jeremy-daily/SSS2/RawHID/README.md

# RawHID for SSS2
This is a development directory to use the human interface device for communication with the PC from the SSS2.
