jeremy-daily/SSS2/docs/SSS-2.0 v5 Schematics.pdf

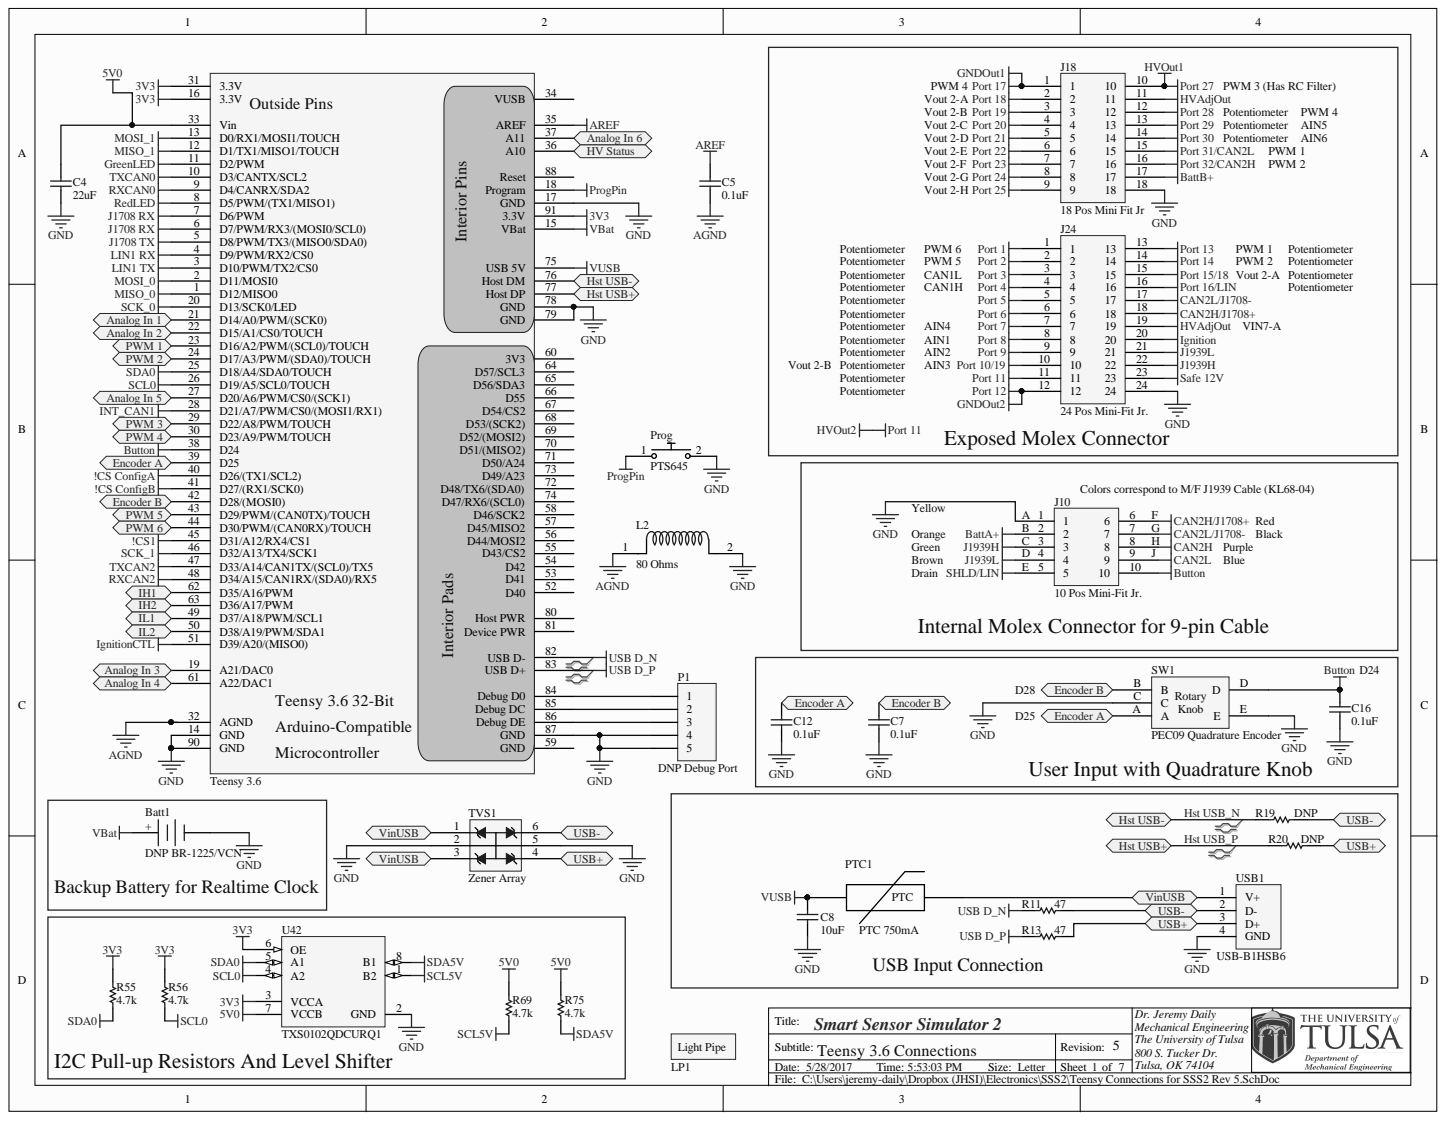
[picture p1: page 1]

Interior Pins Interior Pads

24 Pos Mini-Fit Jr.

10 Pos Mini-Fit Jr.

Internal Molex Connector for 9-pin Cable

User Input with Quadrature Knob

Backup Battery for Realtime Clock

Dr. Jeremy Daily
Mechanical Engineering
The University of Tulsa
800 S. Tucker Dr.
Tulsa, OK 74104

Subtitle:
C:\Users\jeremy-daily\Dropbox (JHSI)\Electronics\SSS2\Teensy Connections for SSS2 Rev 5.SchDoc

I2C Pull-up Resistors And Level Shifter

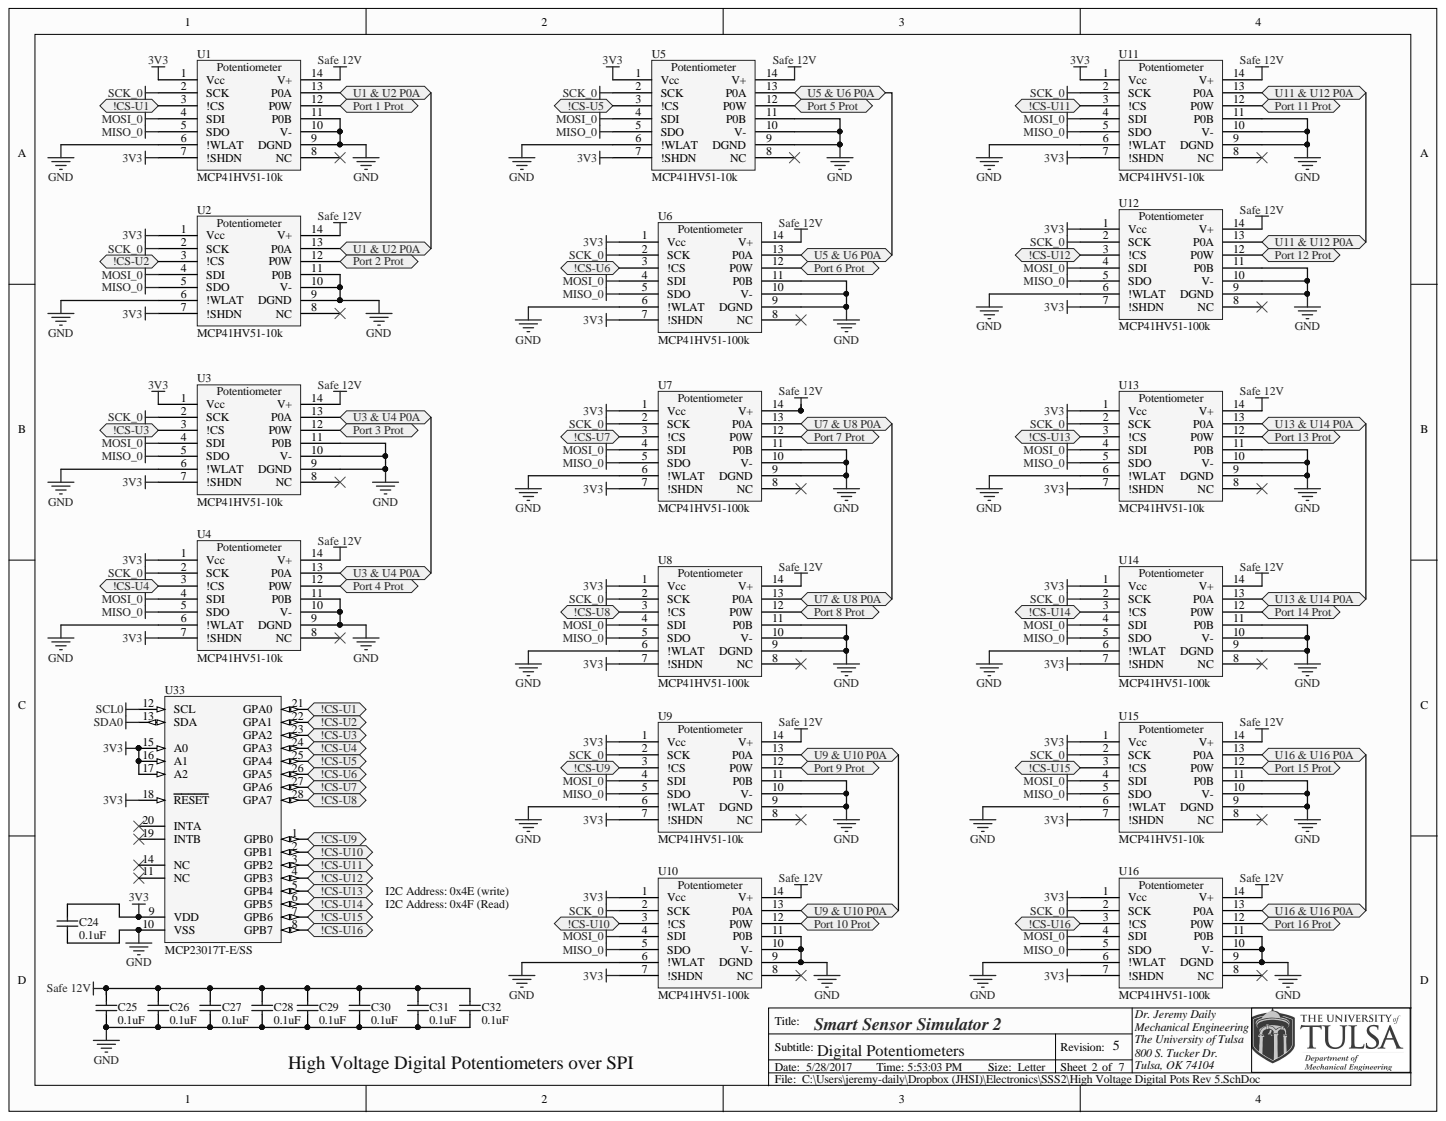
[picture p2: page 2]

Title: Smart Sensor Simulator 2 | Dr. Jeremy Daily 800 S. Tucker Dr.

Digital Potentiometers | 5

High Voltage Digital Potentiometers over SPI

C:\Users\jeremy-daily\Dropbox (JHSI)\Electronics\SSS2\High Voltage Digital Pots Rev 5.SchDoc

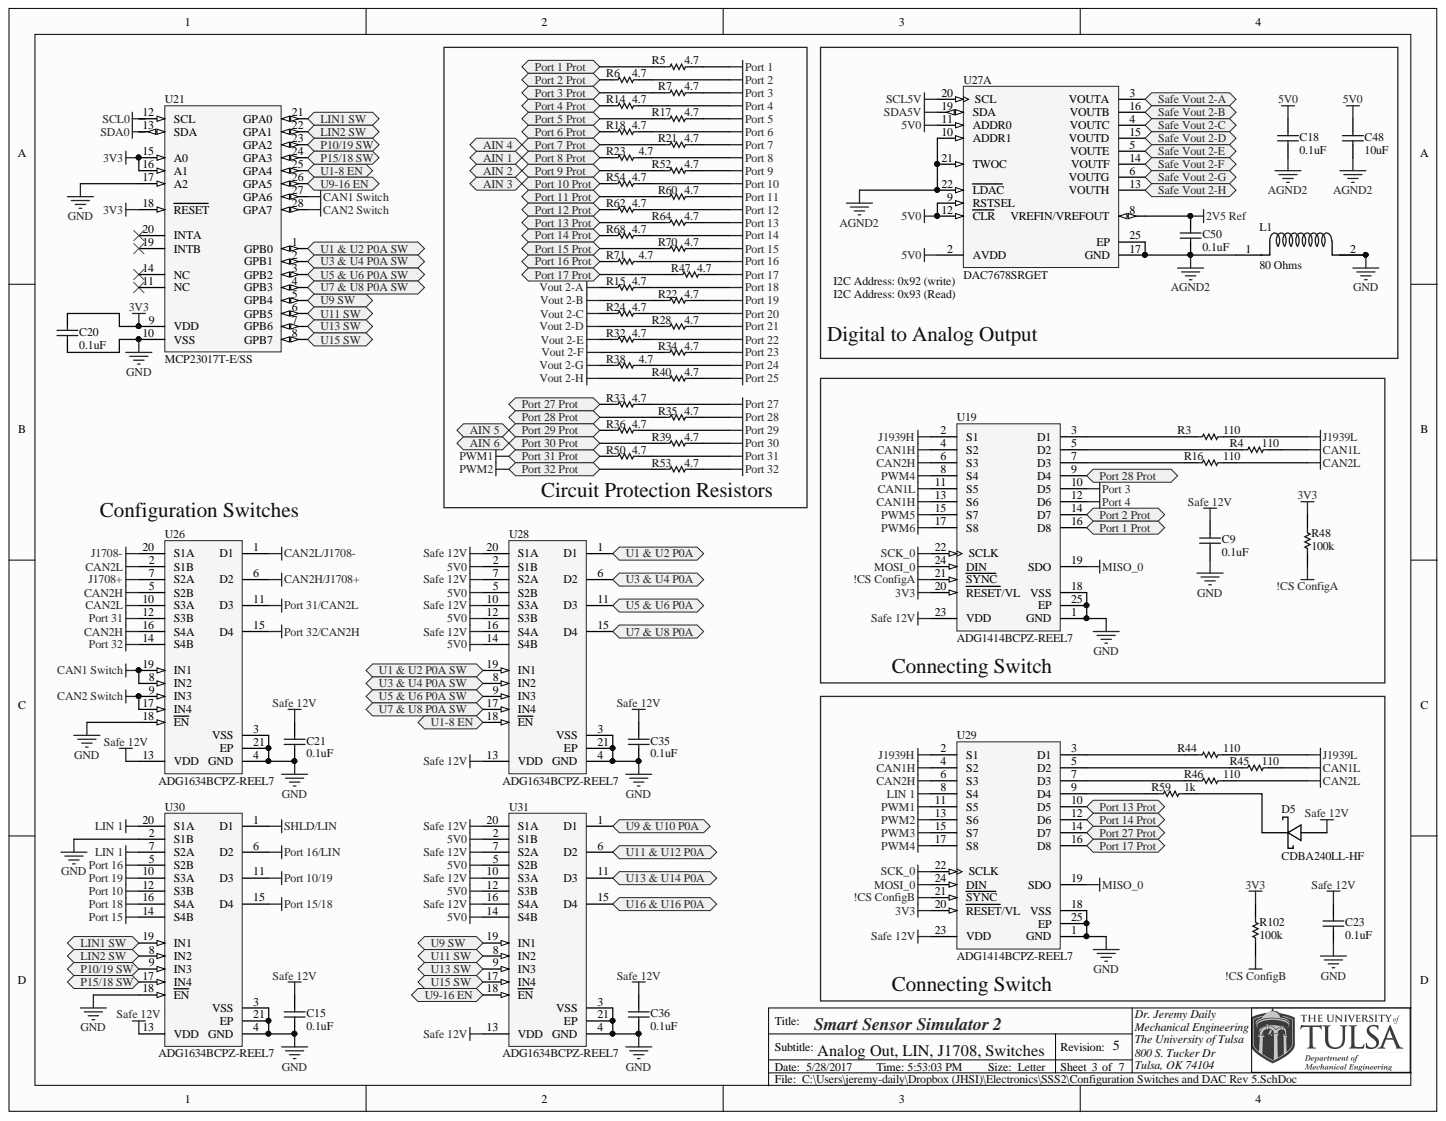
[picture p3: page 3]

Su b ti tle: An alo g Out, LIN, J 8, Switc h e s | Rev i s i o n :

/ / T ime: : : 3 PM Let ter | Sheet o f

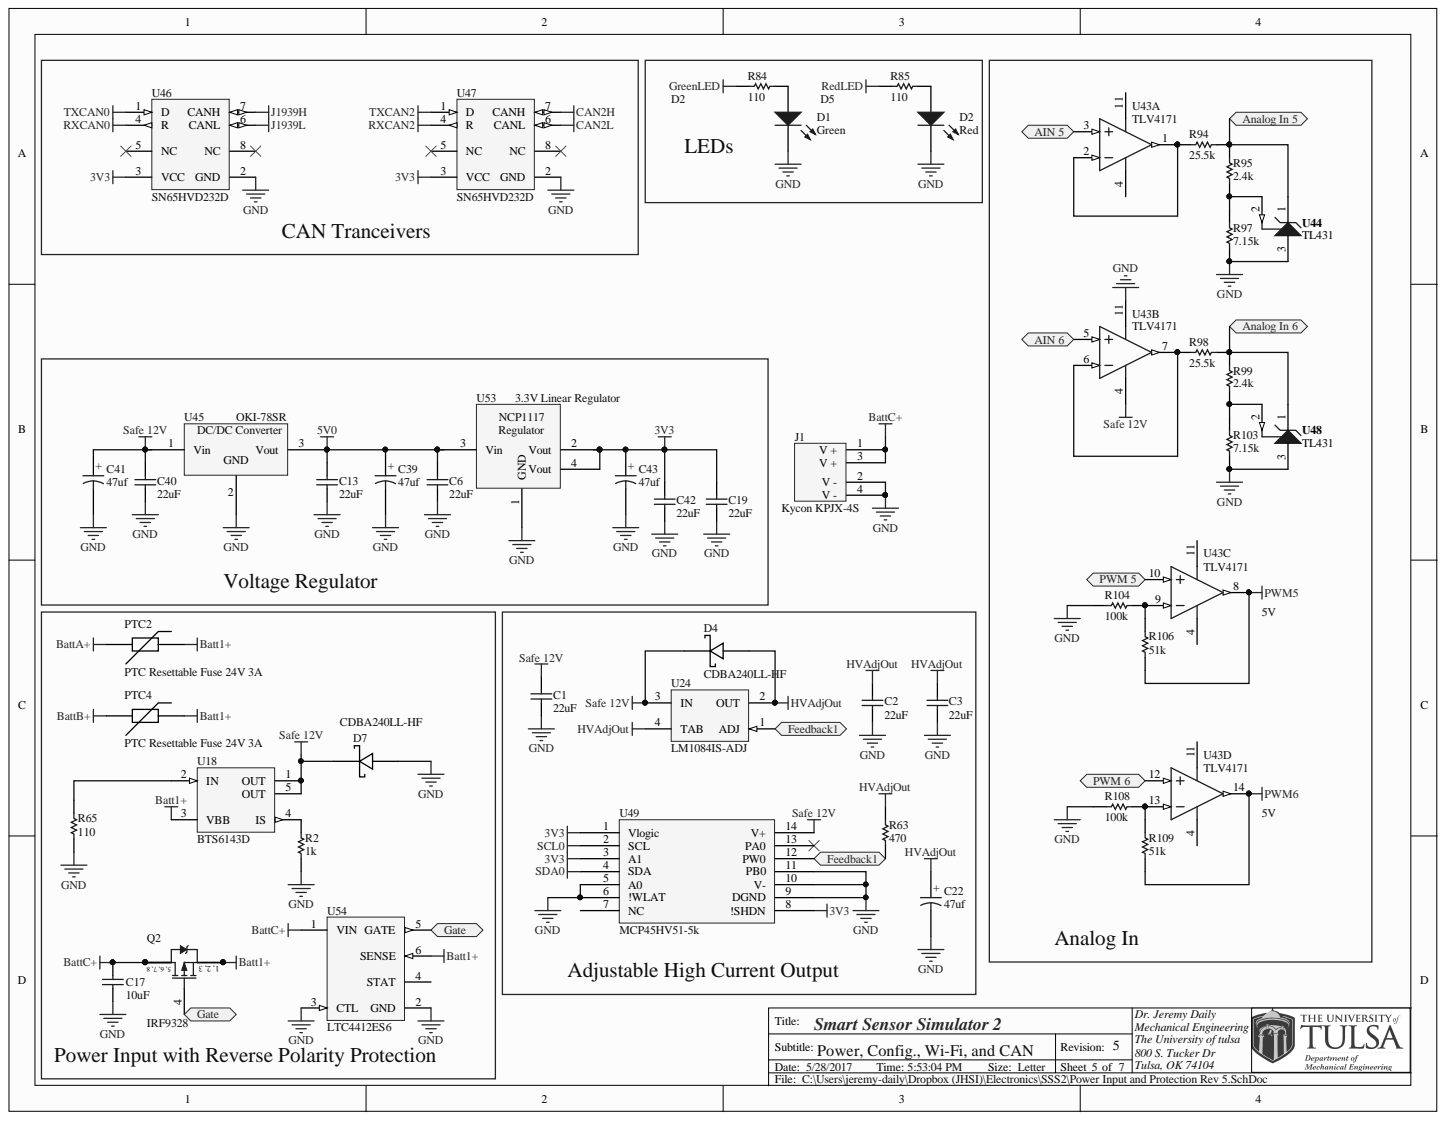
[picture p4: page 4]

Adjustable High Current Output

Power, Config., Wi-Fi, and CAN Time: Letter | 5 Sheet of Power Input with Reverse Polarity Protection

The University of tulsa
800 S. Tucker Dr

C:\Users\jeremy-daily\Dropbox (JHSI)\Electronics\SSS2\Power Input and Protection Rev 5.SchDoc

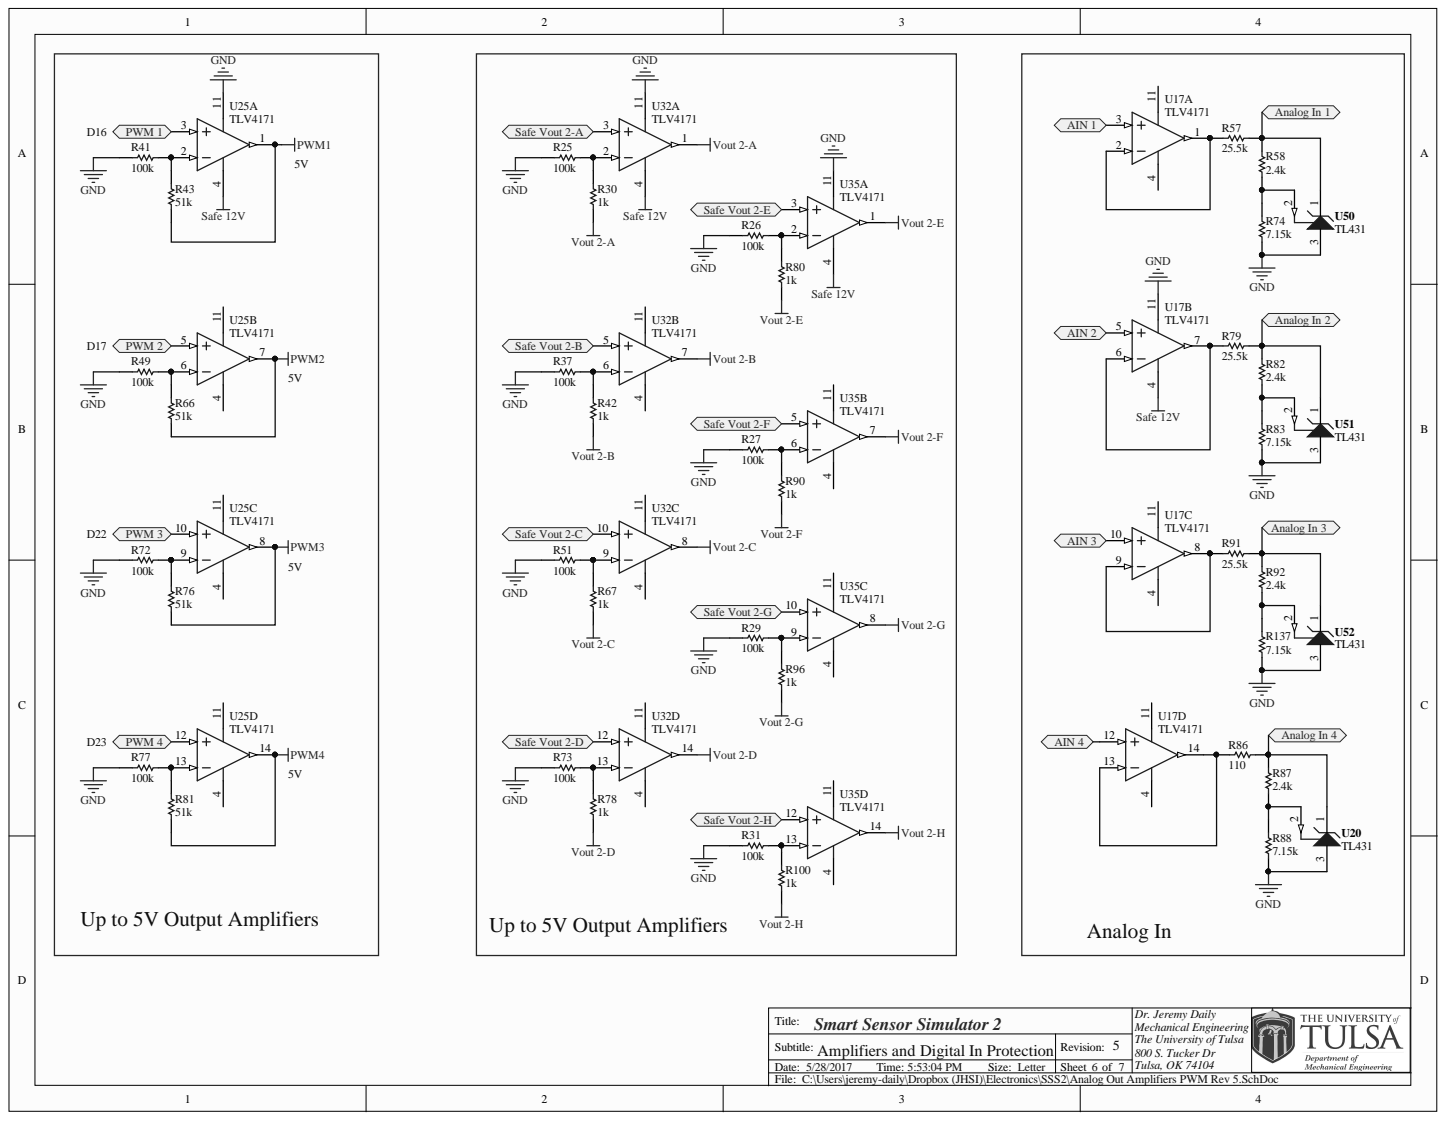
[picture p5: page 5]

T i tle: Smart Sensor Simulator 2 | D r. Jeremy D a i ly Mech a n ica l En g i neer i n g The Un ivers i ty of Tu ls a 0 S. Tucker D r Tu ls a, OK 74

Su b ti tle: Amplifiers a n d Digital In Prote ctio n | Rev i s i o n :

/ / T ime: : : 4 PM Let ter | Sheet o f

ifiers PWM Rev 5.Sch

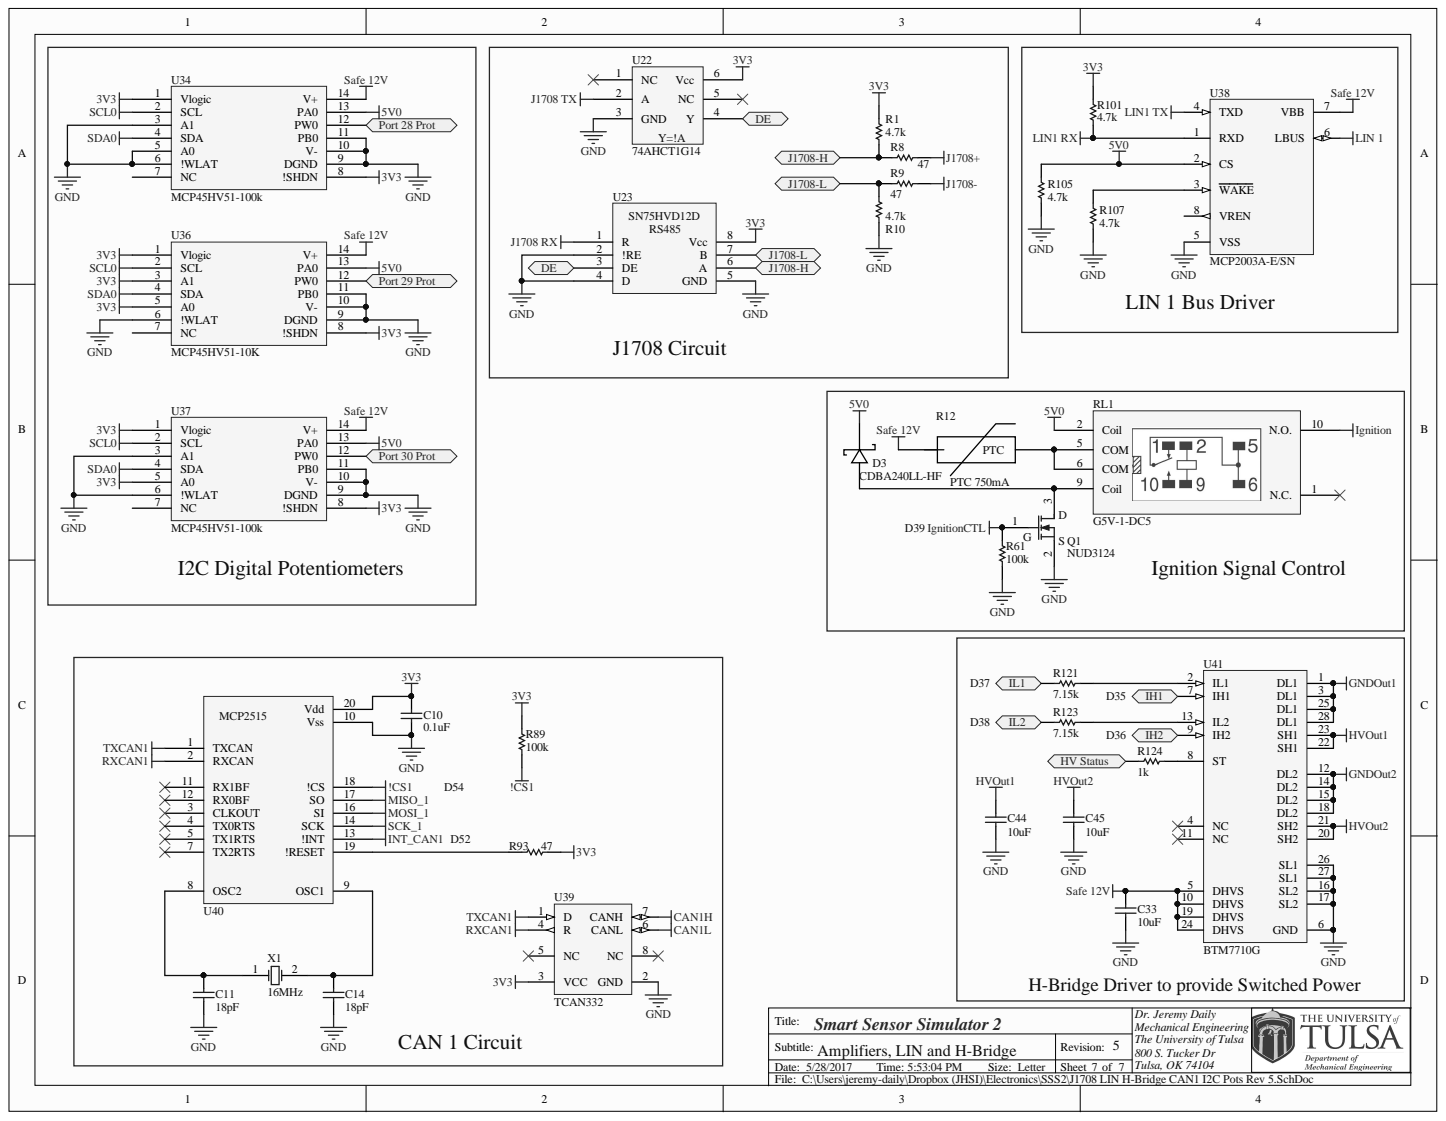
[picture p6: page 6]

H-Bridge Driver to provide Switched Power

C:\Users\jeremy-daily\Dropbox (JHSI)\Electronics\SSS2\J1708 LIN H-Bridge CAN1 I2C Pots Rev 5.SchDoc
