jeremy-daily/SSS2/docs/SSS-2.0 v2 Schematics.pdf

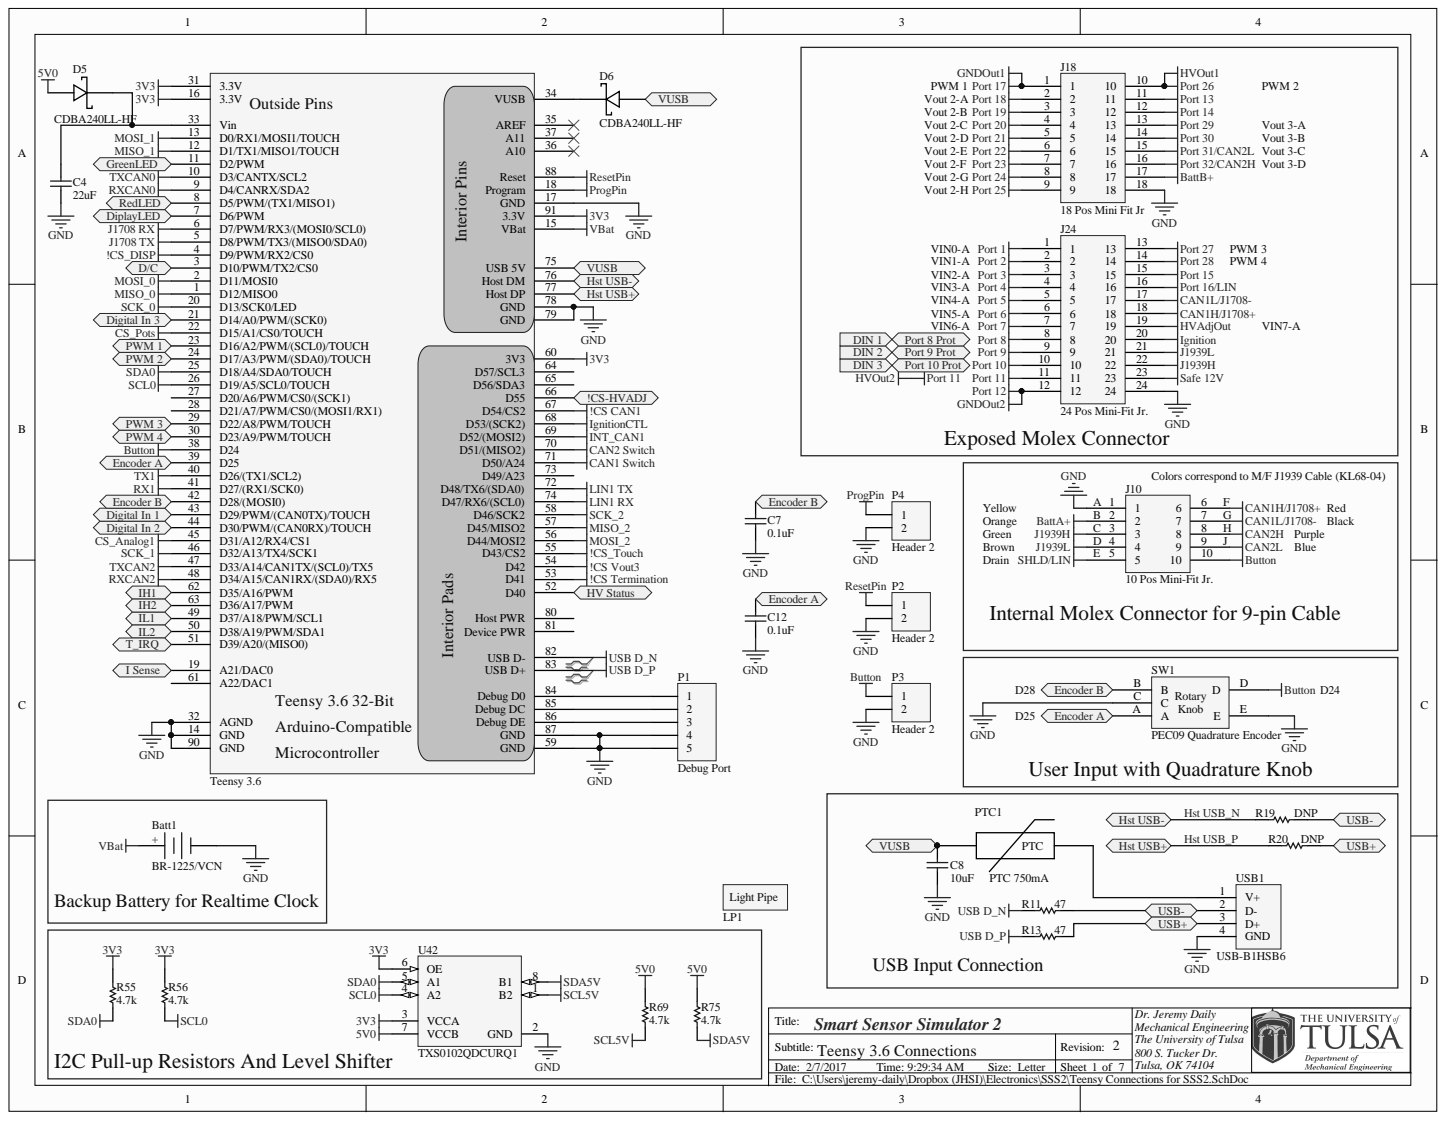
[picture p7: page 1]

Interior Pins Interior Pads

24 Pos Mini-Fit Jr.

10 Pos Mini-Fit Jr.

Internal Molex Connector for 9-pin Cable

User Input with Quadrature Knob

Backup Battery for Realtime Clock

Title: Smart Sensor Simulator 2 | Dr. Jeremy Daily Mechanical Engineering The University of Tulsa 800 S. Tucker Dr. Tulsa, OK 74104

Teensy 3.6 Connections Subtitle: | 2 Revision:

I2C Pull-up Resistors And Level Shifter

Date: 2/7/2017 Time: 9:29:34 AM Size: Letter | Sheet of

C:\Users\jeremy-daily\Dropbox (JHSI)\Electronics\SSS2\Teensy Connections for SSS2.SchDoc

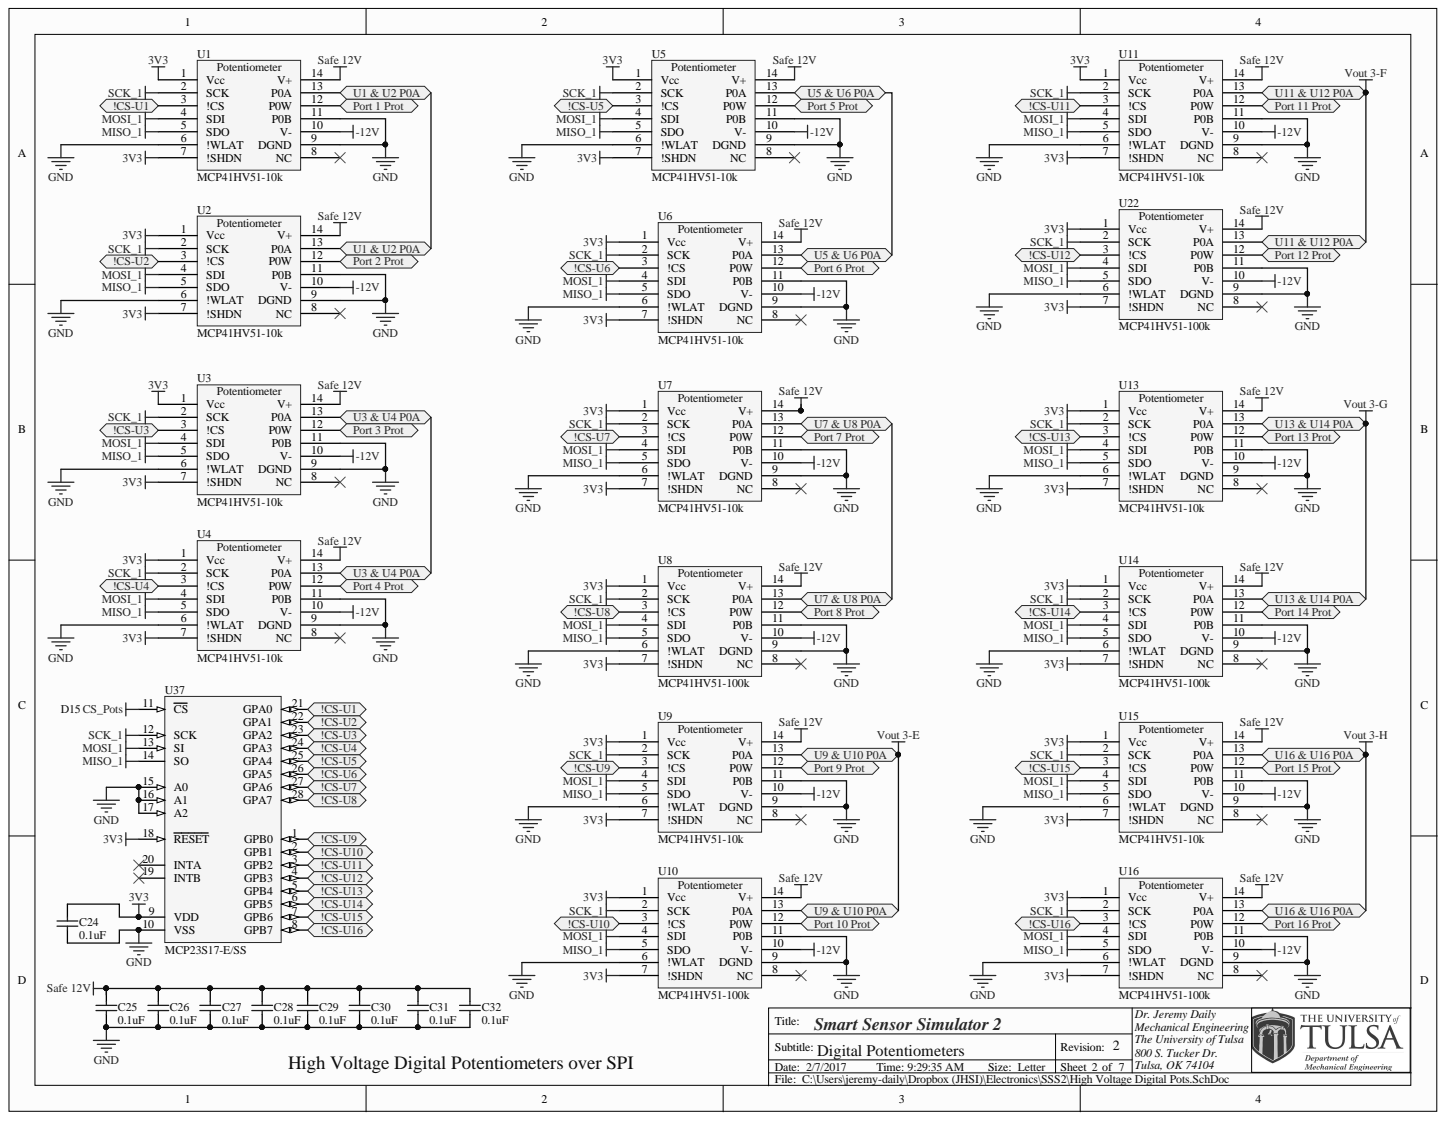
[picture p8: page 2]

Title: Smart Sensor Simulator 2 | Dr. Jeremy Daily The University of Tulsa 800 S. Tucker Dr.

Digital Potentiometers | 2

High Voltage Digital Potentiometers over SPI

C:\Users\jeremy-daily\Dropbox (JHSI)\Electronics\SSS2\High Voltage Digital Pots.SchDoc

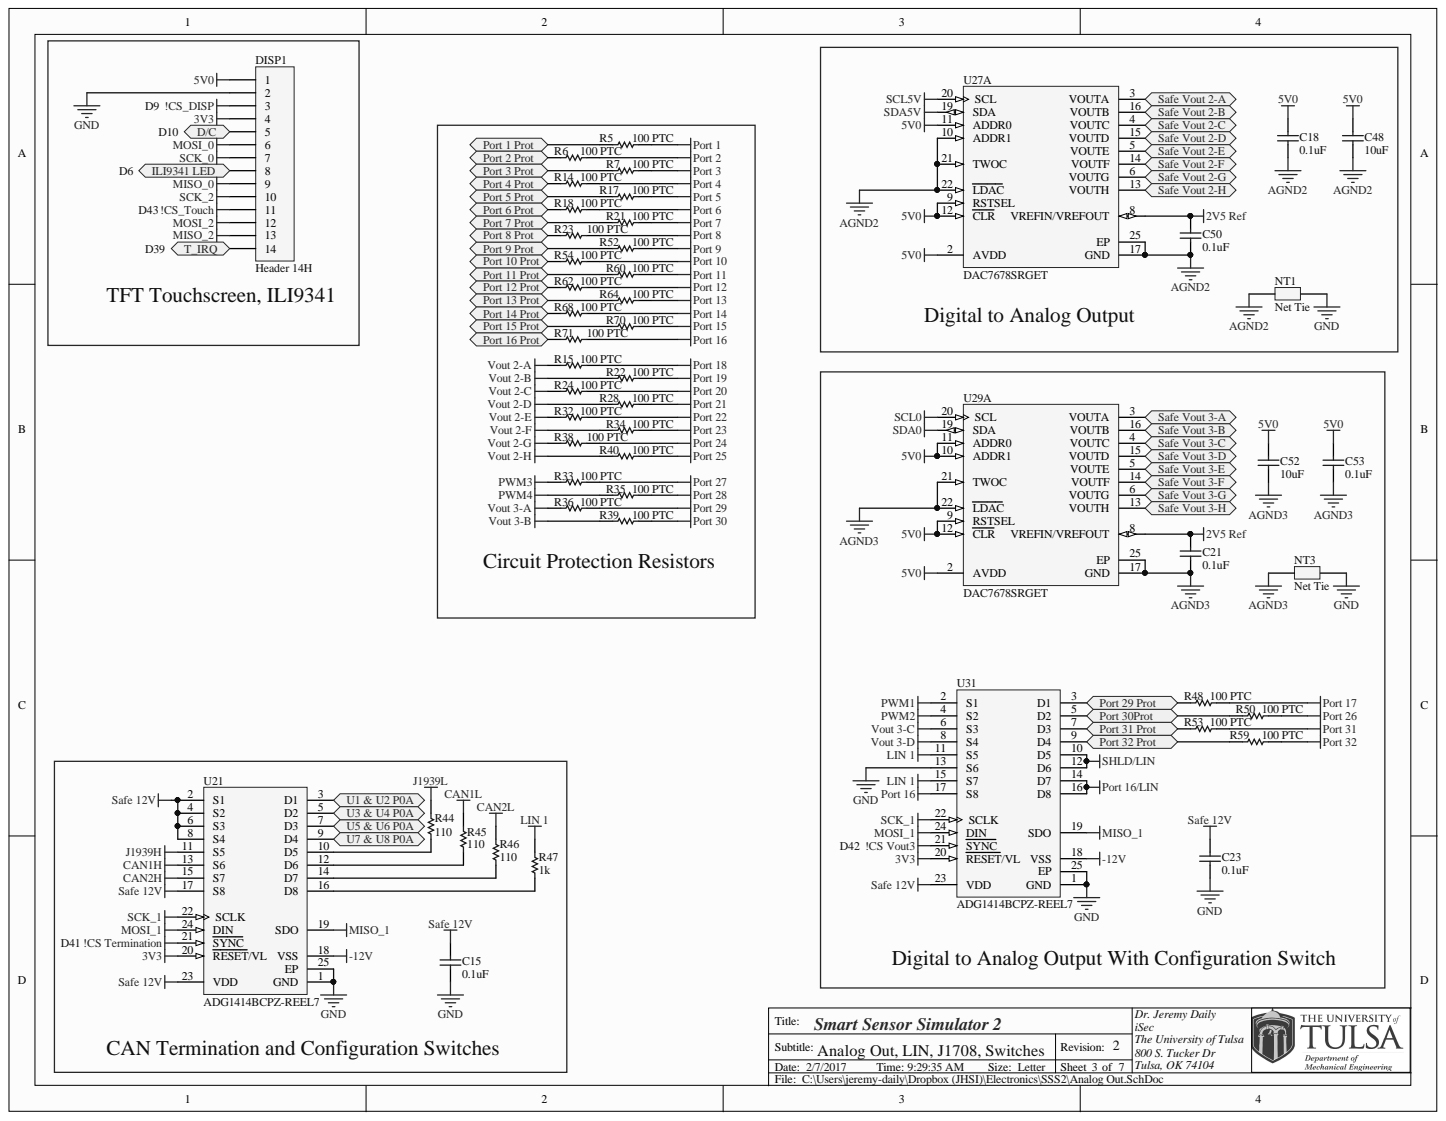
[picture p9: page 3]

Digital to Analog Output

1 3 | 1
1 5 | 1
1 7 | 1

Digital to Analog Output With Configuration Switch

T i tle: Smart Sensor Simulator 2 | D r. Jeremy D a i ly Sec 800 S. Tucker D The Un ivers i ty of Tu ls a r Tu a, OK 74

CAN Termination and Configuration Switches

Su ti tle: An alo g Out, LIN, J 8, Switc h e s | Rev

/ T ime: : 5 A M Let ter | Sheet f

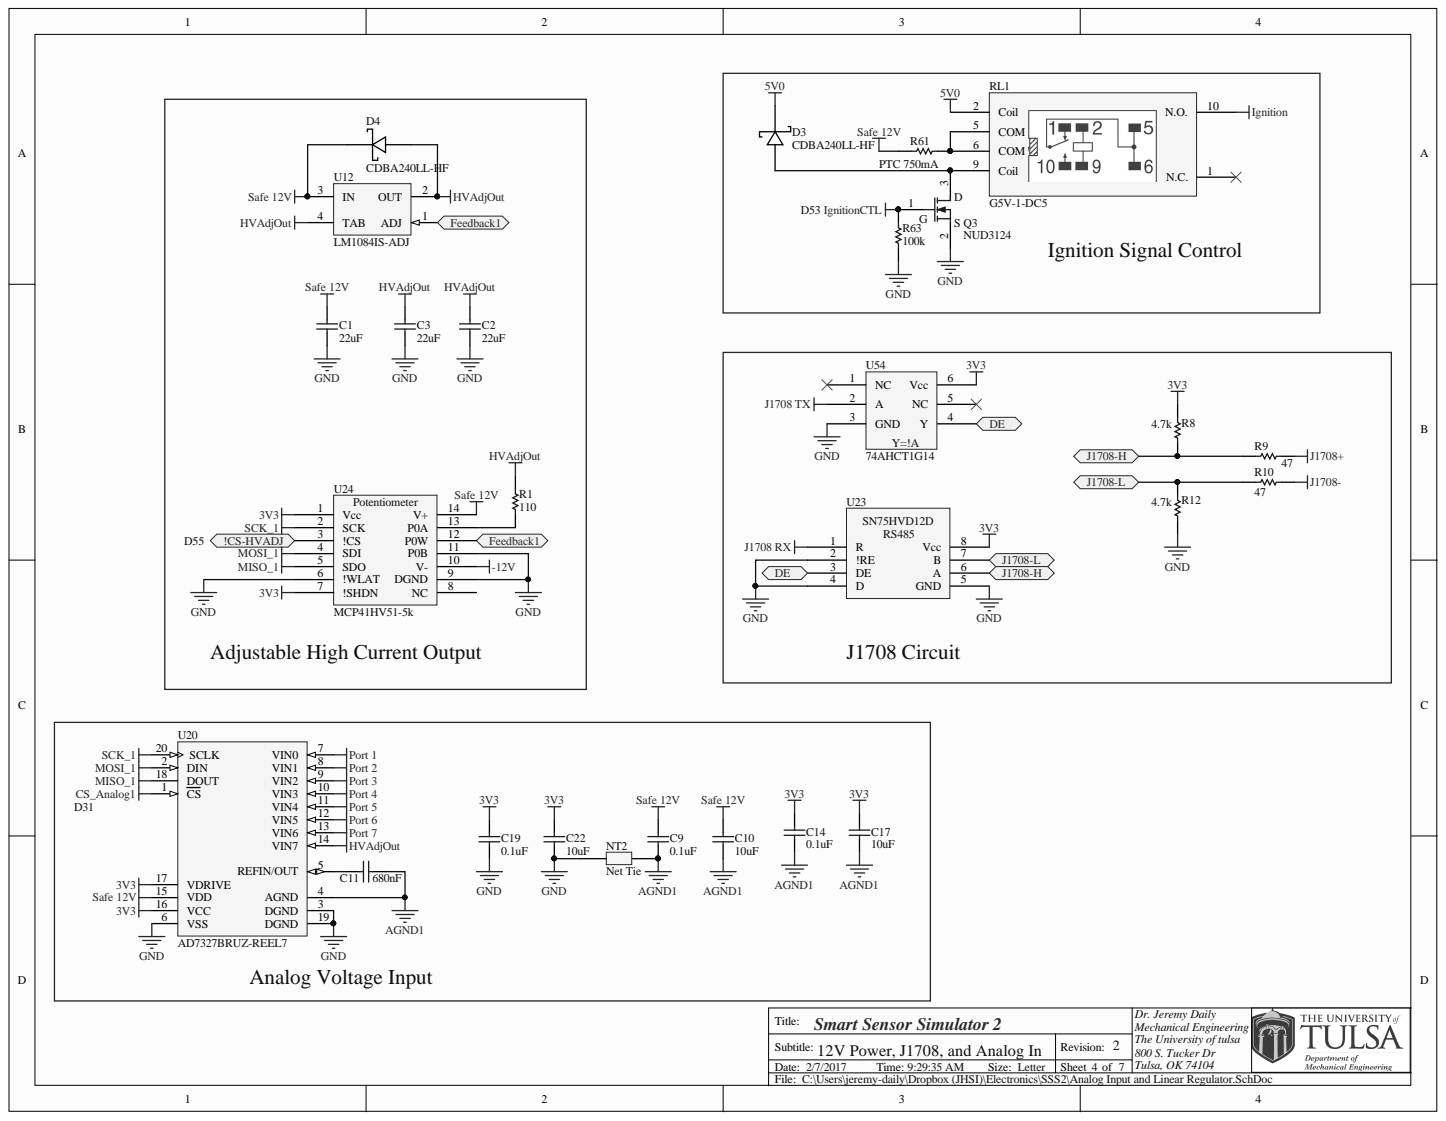
[picture p10: page 4]

Adjustable High Current Output

Title: Smart Sensor Simulator 2 | Dr. Jeremy Daily The University of tulsa 800 S. Tucker Dr

12V Power, J1708, and Analog In | 2

C:\Users\jeremy-daily\Dropbox (JHSI)\Electronics\SSS2\Analog Input and Linear Regulator.SchDoc

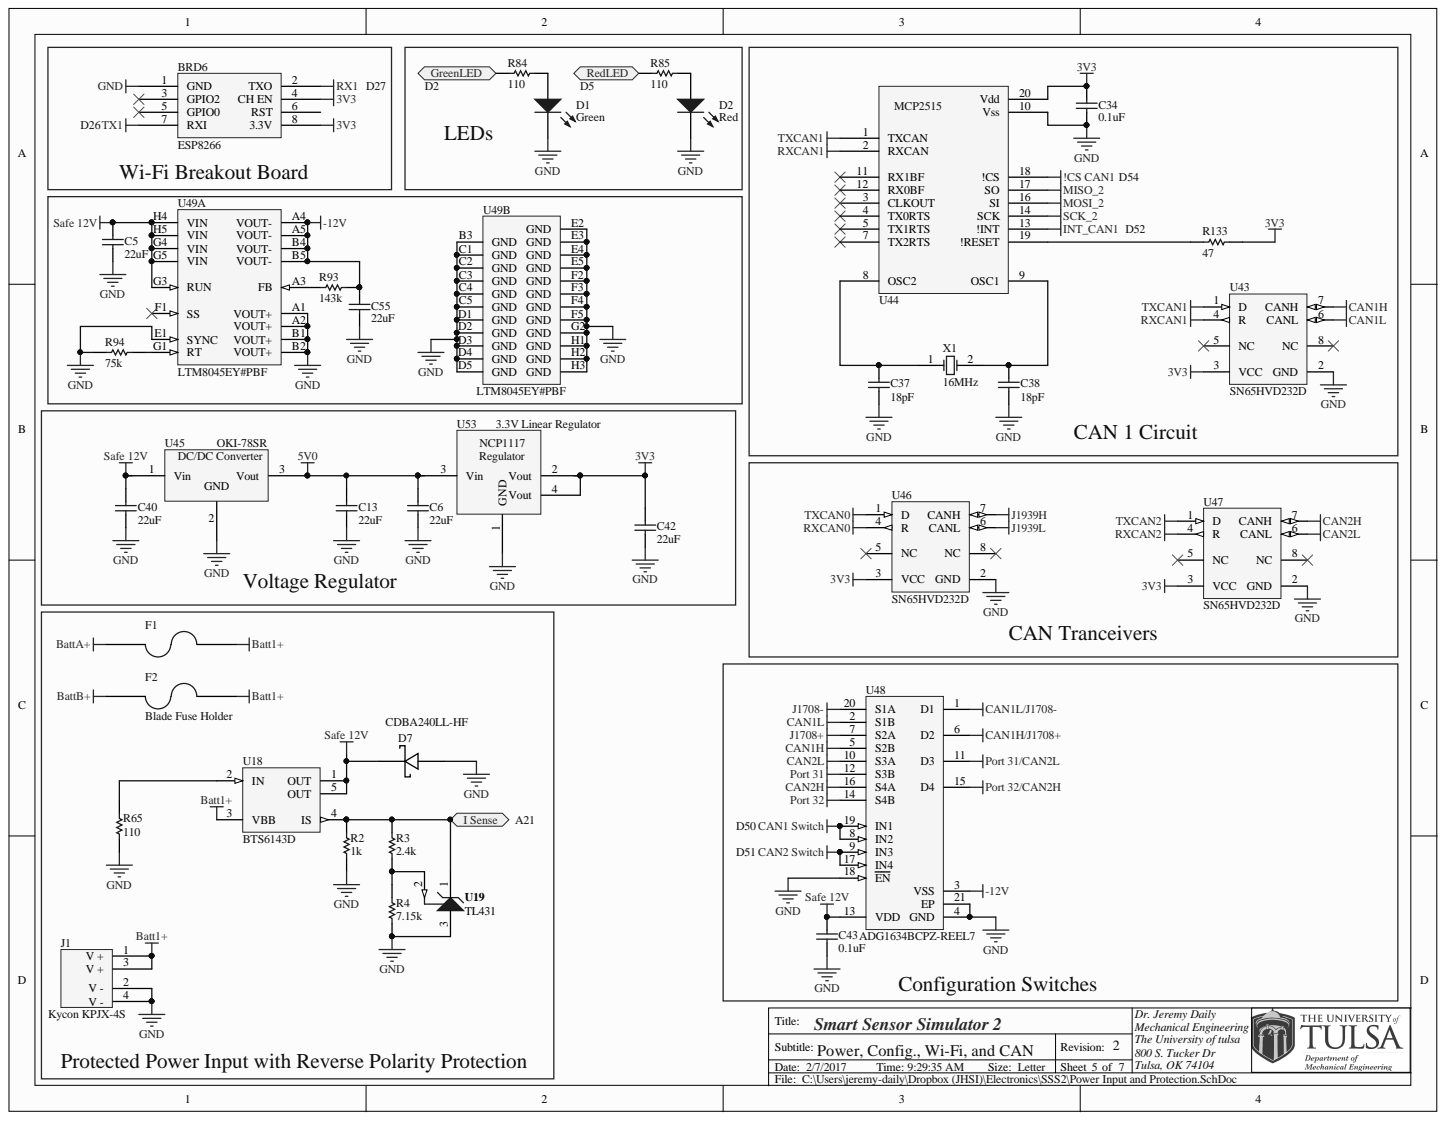
[picture p11: page 5]

Wi-Fi Breakout Board

Title: Smart Sensor Simulator 2 | Dr. Jeremy Daily The University of tulsa 800 S. Tucker Dr

Power, Config., Wi-Fi, and CAN | 2

Protected Power Input with Reverse Polarity Protection

C:\Users\jeremy-daily\Dropbox (JHSI)\Electronics\SSS2\Power Input and Protection.SchDoc

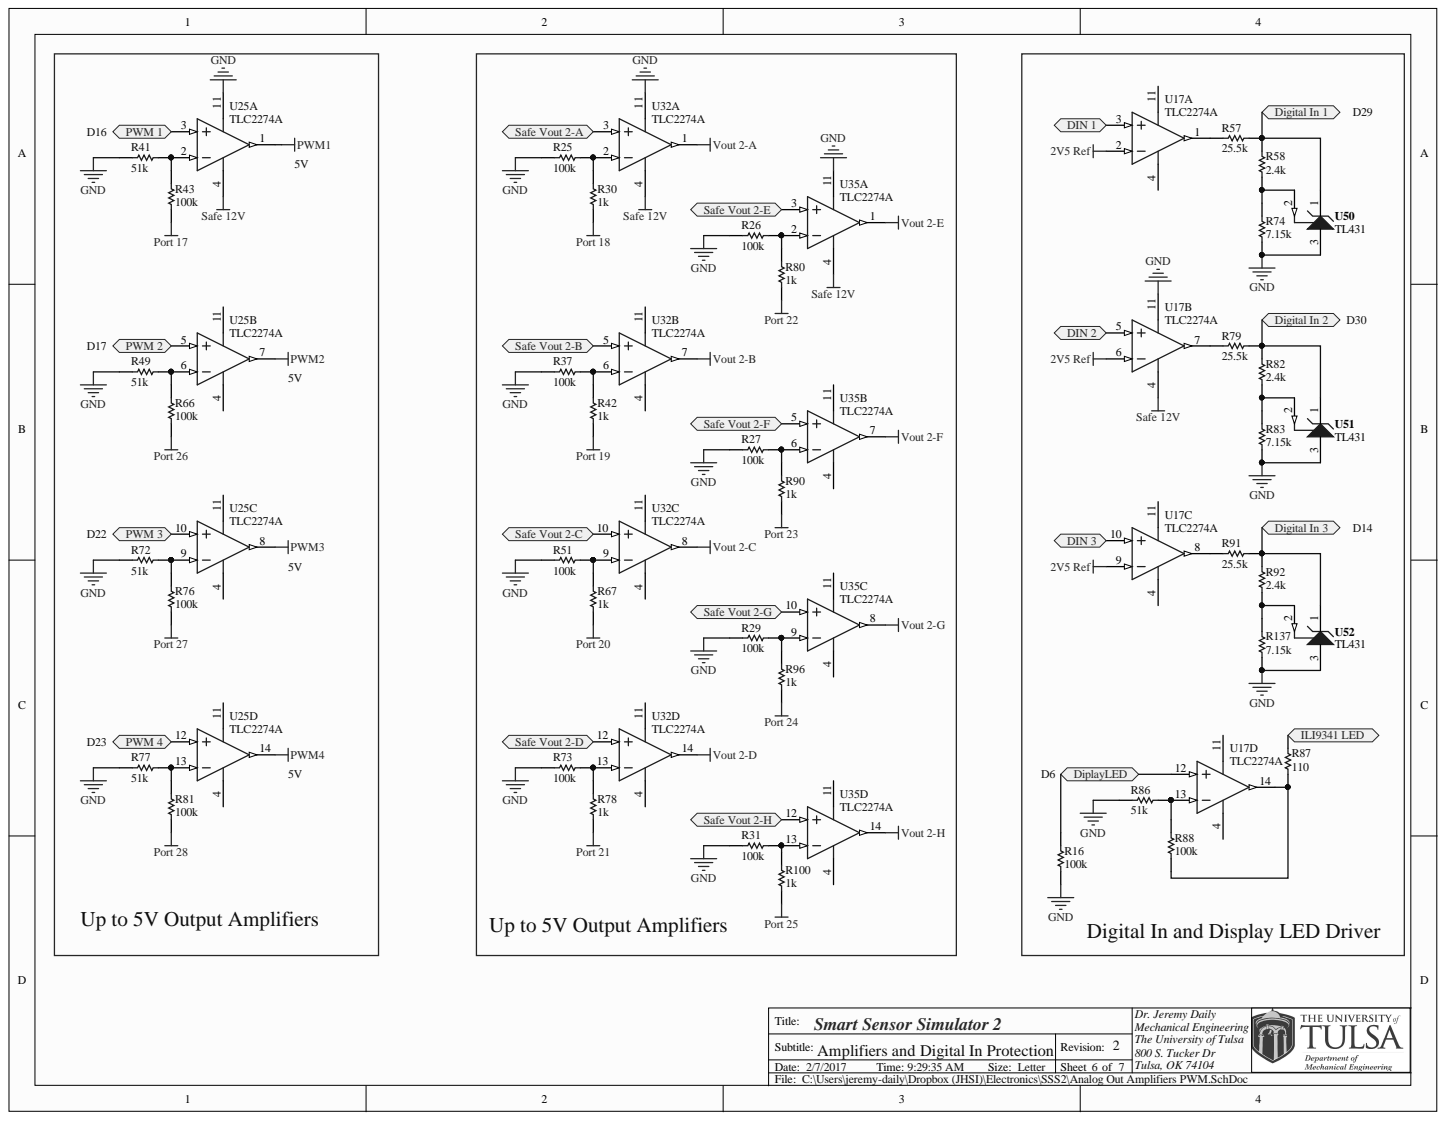
[picture p12: page 6]

T i tle: Smart Sensor Simulator 2 | D r. Jeremy D a i ly Mech ica l En g neer g 0 S. Tucker D

Amplifiers a d Digital In Prote ctio

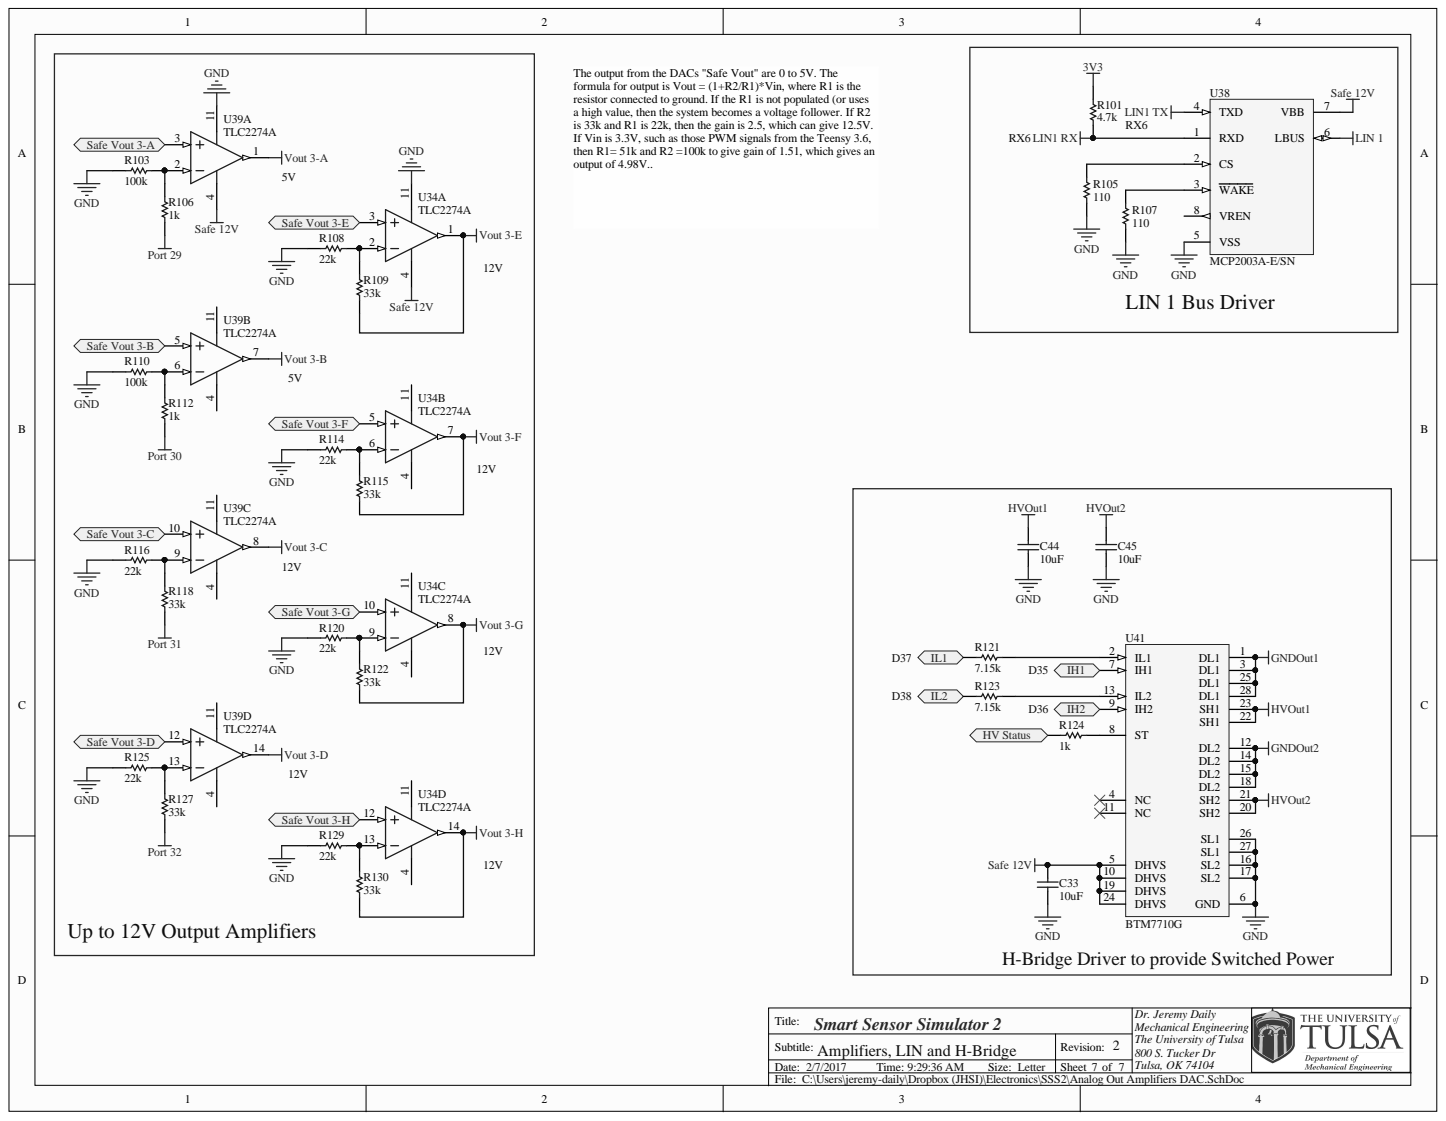
[picture p13: page 7]

ge Driver to pro

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

Amplifiers, LIN a d H-Brid g e
