jeremy-daily/SSS2/docs/SSS-2.0 v3 Schematics.pdf

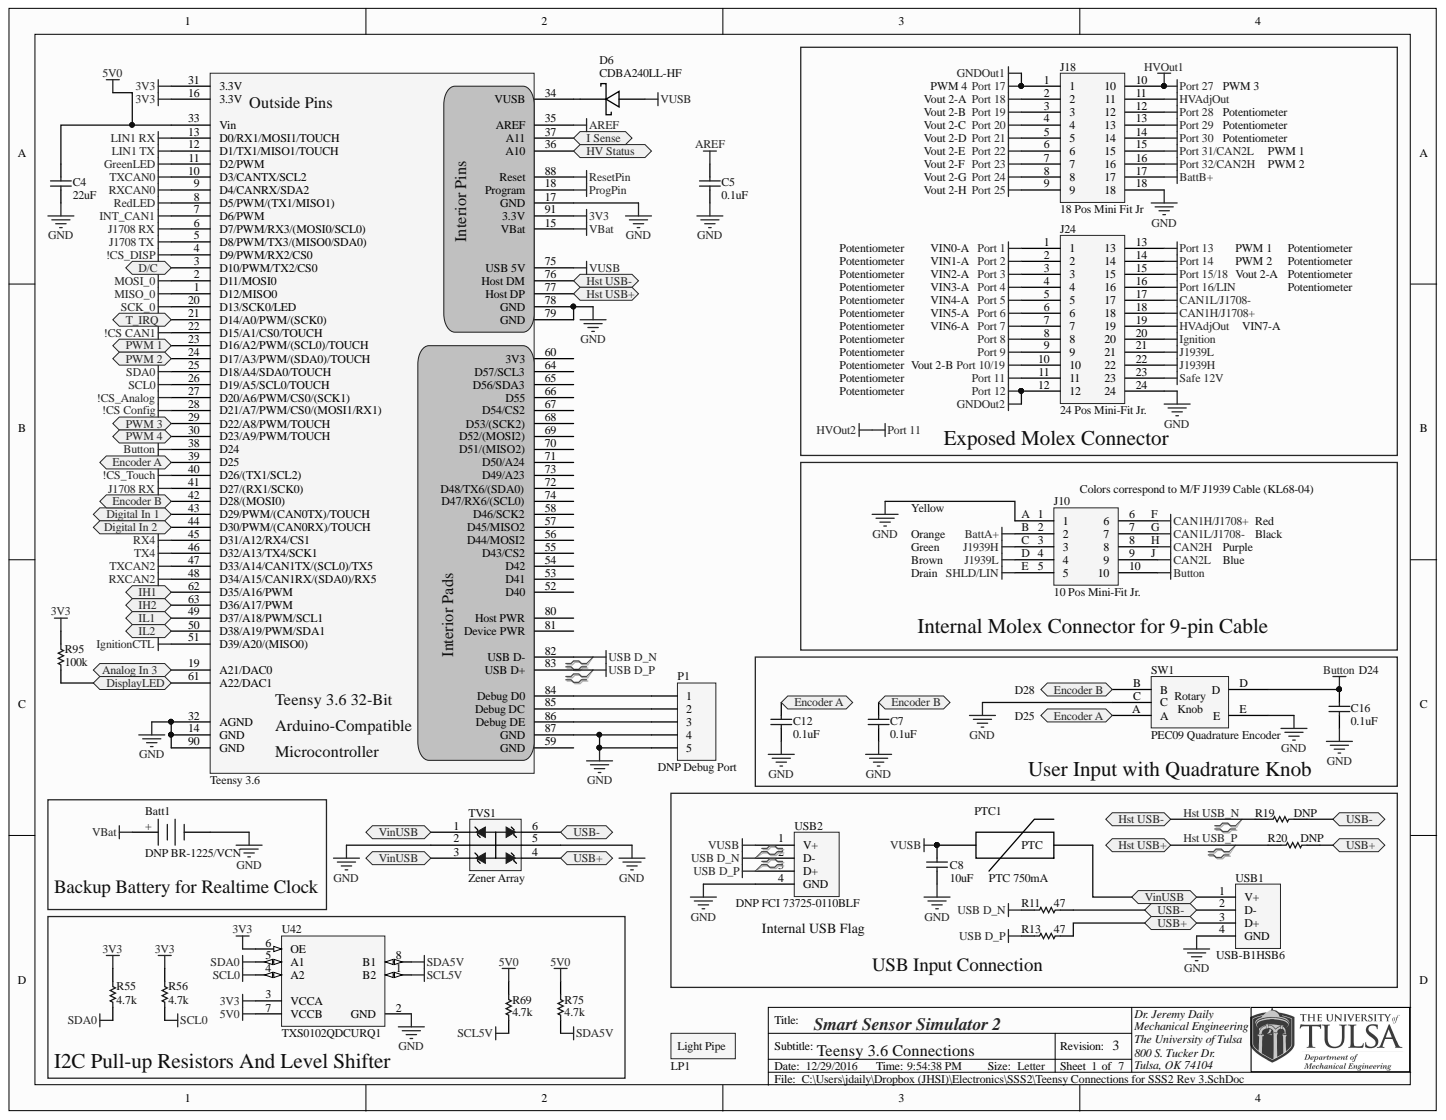
[picture p14: page 1]

Interior Pins Interior Pads

24 Pos Mini-Fit Jr.

10 Pos Mini-Fit Jr.

Internal Molex Connector for 9-pin Cable

User Input with Quadrature Knob

Backup Battery for Realtime Clock

Dr. Jeremy Daily
Mechanical Engineering
The University of Tulsa
800 S. Tucker Dr. Tulsa, OK 74104

Subtitle:
C:\Users\jdaily\Dropbox (JHSI)\Electronics\SSS2\Teensy Connections for SSS2 Rev 3.SchDoc

I2C Pull-up Resistors And Level Shifter

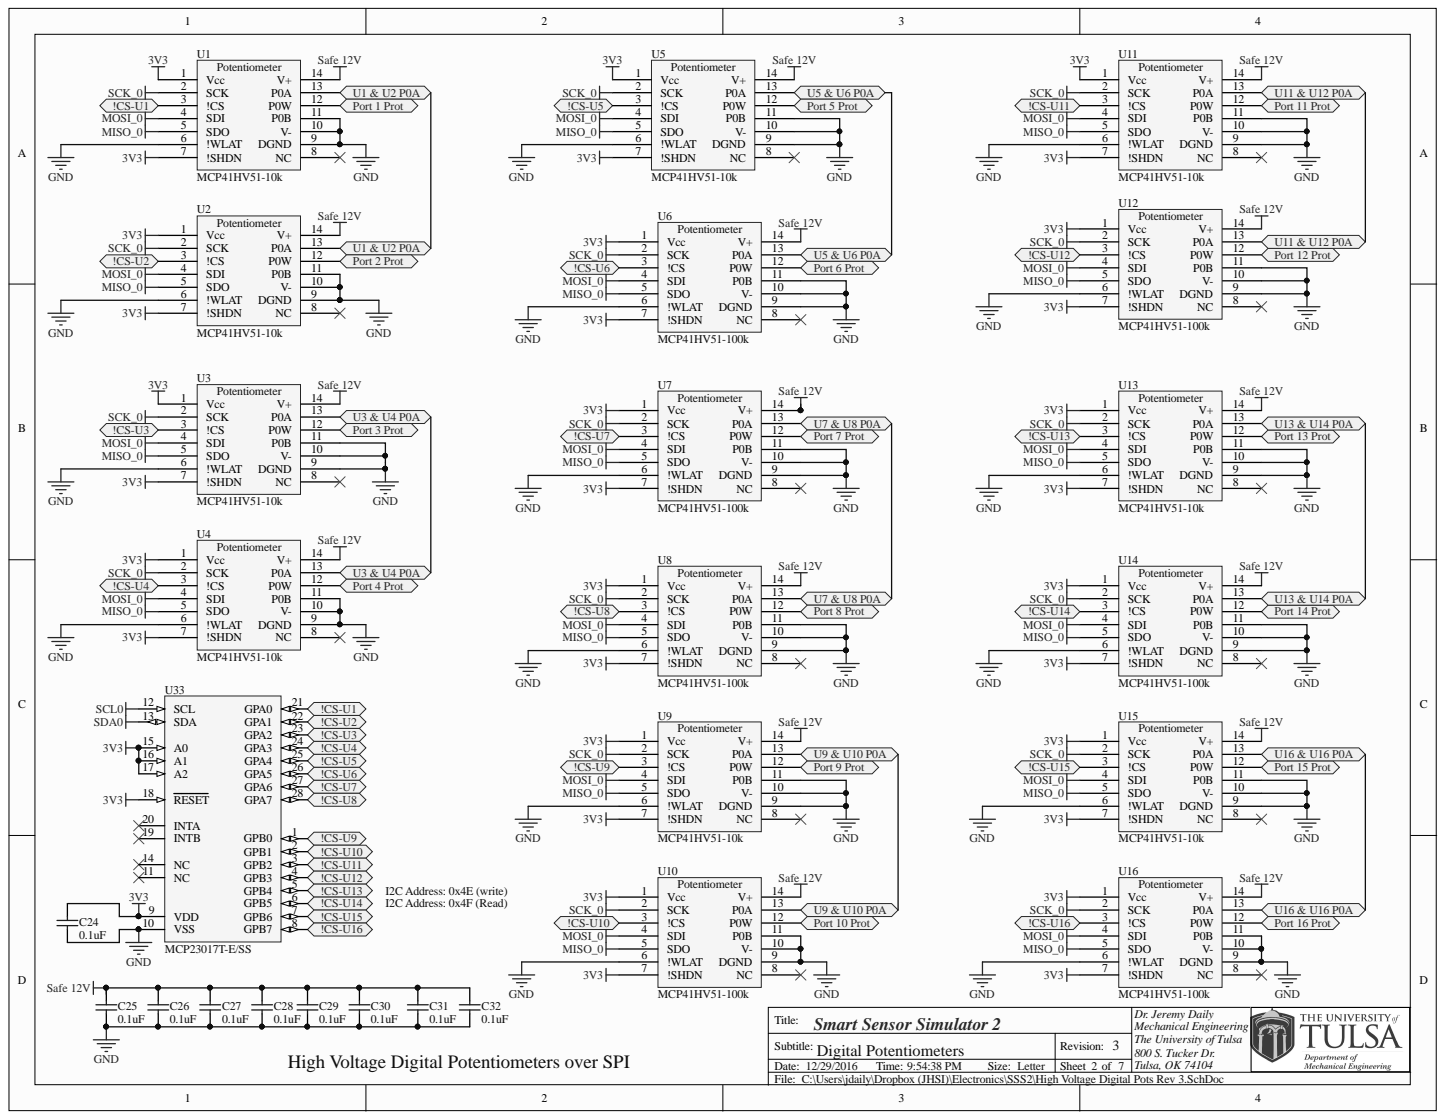
[picture p15: page 2]

Title: Smart Sensor Simulator 2 | Dr. Jeremy Daily 800 S. Tucker Dr. Tulsa, OK 74104

Digital Potentiometers | 3

High Voltage Digital Potentiometers over SPI

C:\Users\jdaily\Dropbox (JHSI)\Electronics\SSS2\High Voltage Digital Pots Rev 3.SchDoc

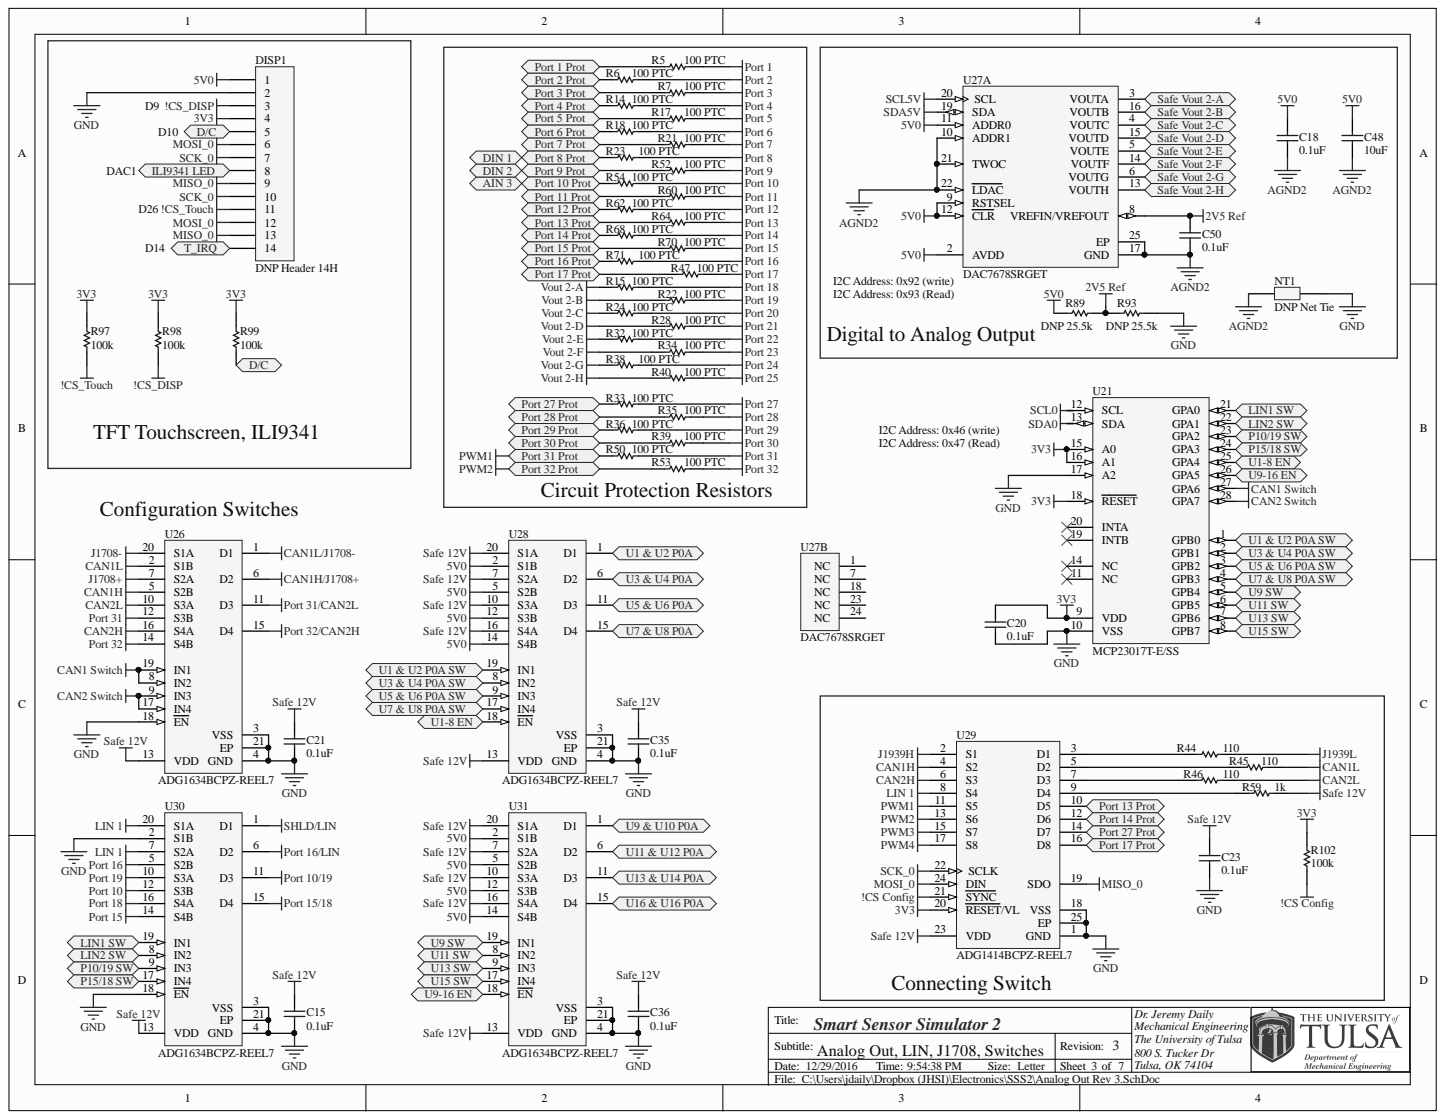
[picture p16: page 3]

1 1 | Port 1
1 3 | 1

Su b ti tle: An alo g Out, LIN, J 8, Switc h e s | Rev i s i o n :

2/ / Time: : : 8 PM Let ter | Sheet o f

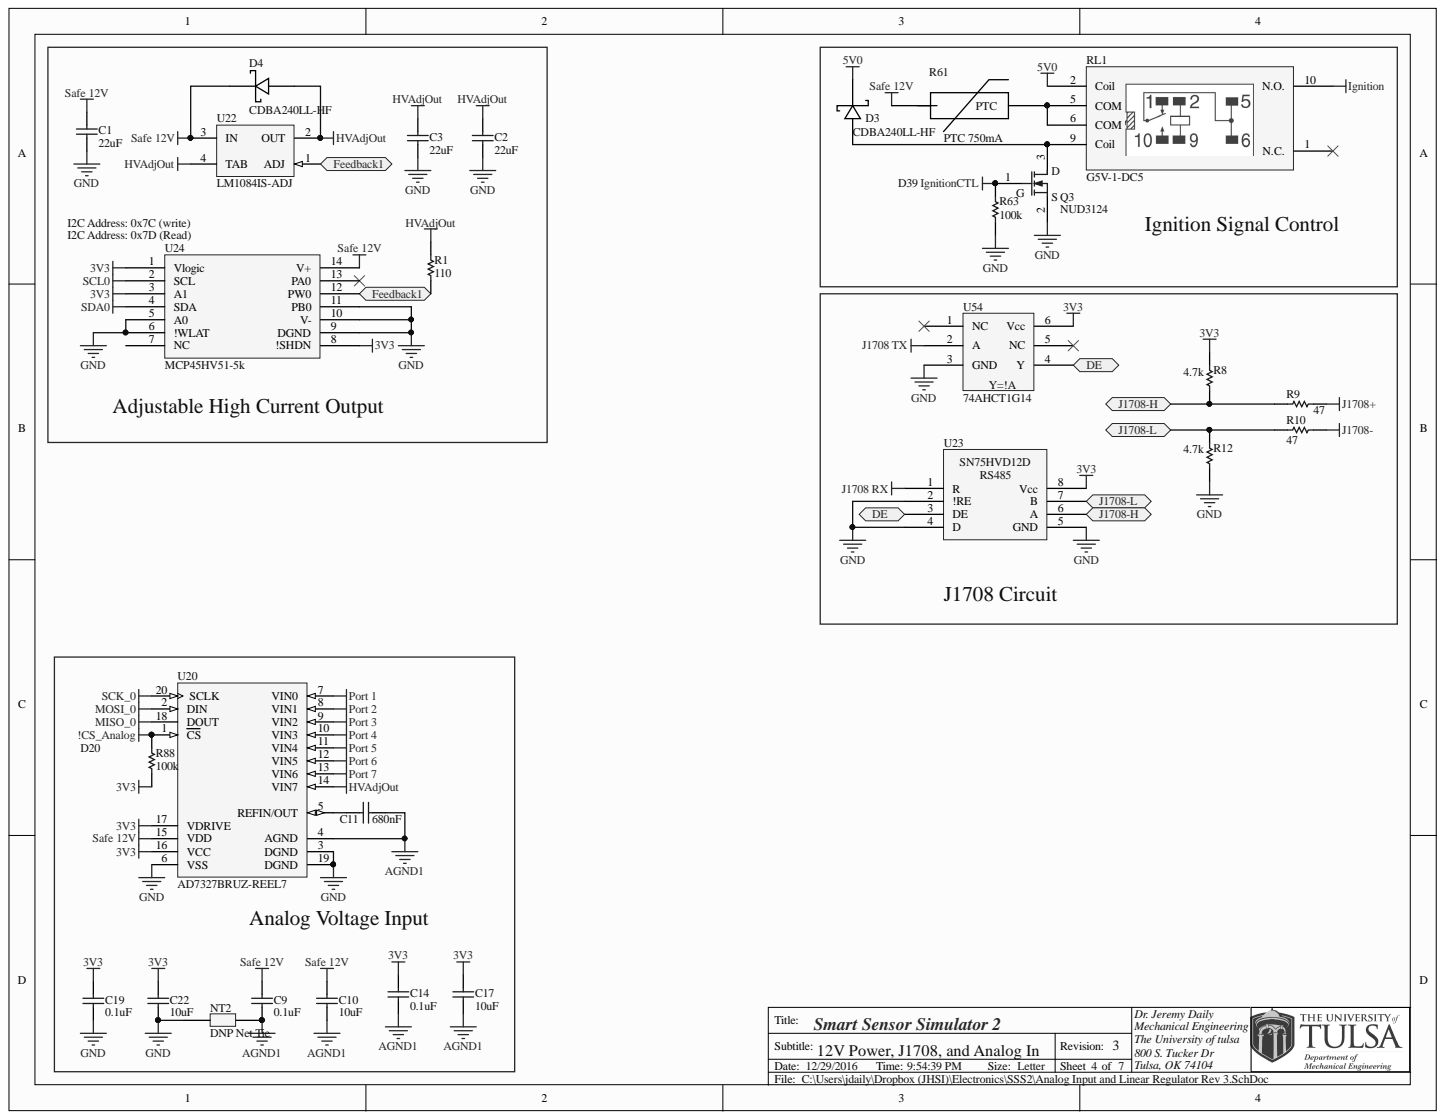
[picture p17: page 4]

Adjustable High Current Output

Title: Smart Sensor Simulator 2 | Dr. Jeremy Daily The University of tulsa 800 S. Tucker Dr Tulsa, OK 74104

12V Power, J1708, and Analog In | 3

C:\Users\jdaily\Dropbox (JHSI)\Electronics\SSS2\Analog Input and Linear Regulator Rev 3.SchDoc

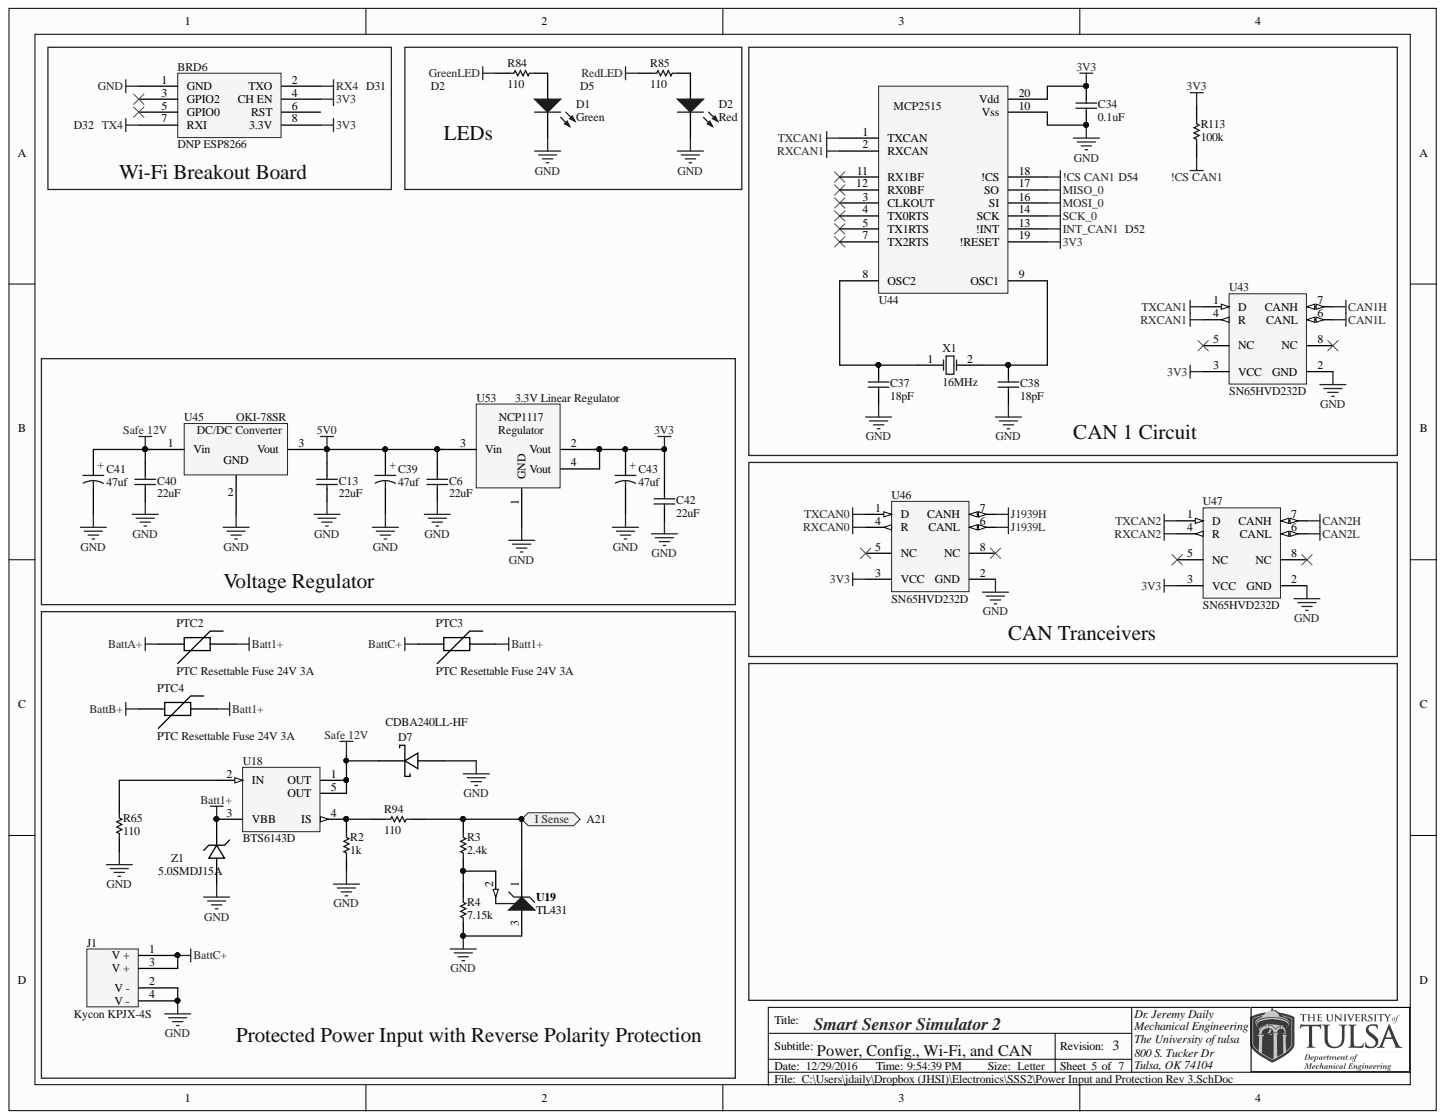
[picture p18: page 5]

Wi-Fi Breakout Board

Title: Smart Sensor Simulator 2 | Dr. Jeremy Daily The University of tulsa

Protected Power Input with Reverse Polarity Protection

Power, Config., Wi-Fi, and CAN | 3

C:\Users\jdaily\Dropbox (JHSI)\Electronics\SSS2\Power Input and Protection Rev 3.SchDoc

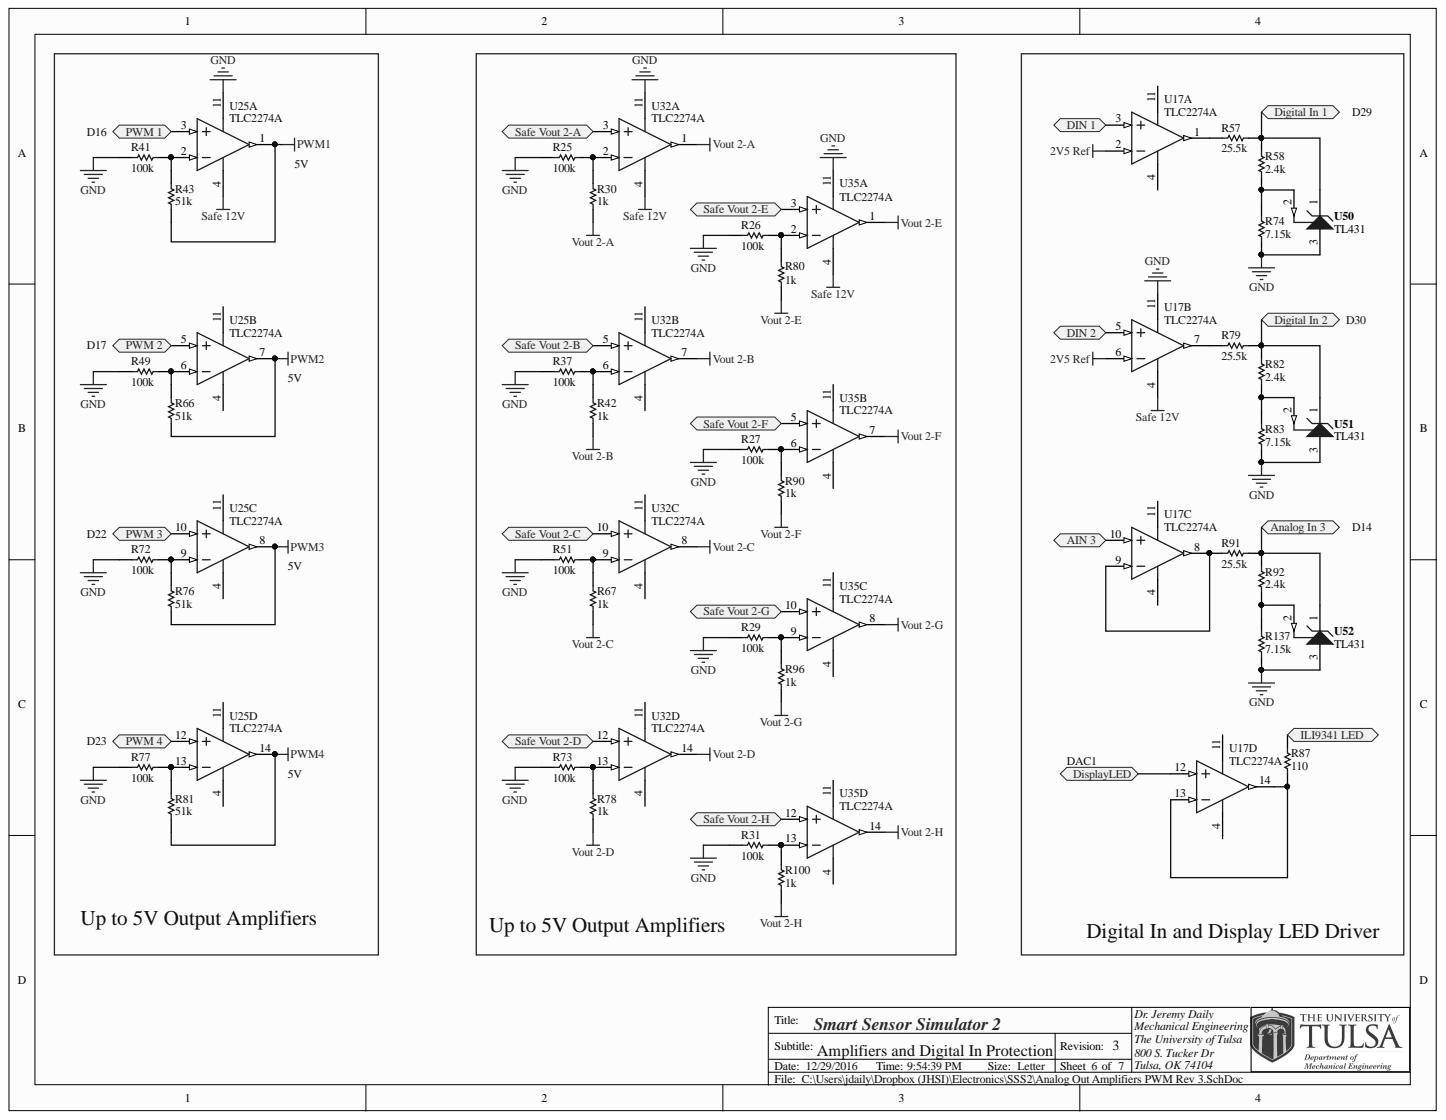
[picture p19: page 6]

Ti tle: Smart Sensor Simulator 2 | D r. Jeremy D a i ly Mech a n ica l En g i neer i n g The Un ivers i ty of Tu ls a 0 S. Tucker D r Tu ls a, OK 74

Su b ti tle: Amplifiers a n d Digital In Prote ctio n | Rev i s i o n :

2/ / Time: : : 9 PM Let ter | Sheet o f

ifiers PWM Rev 3.Sch

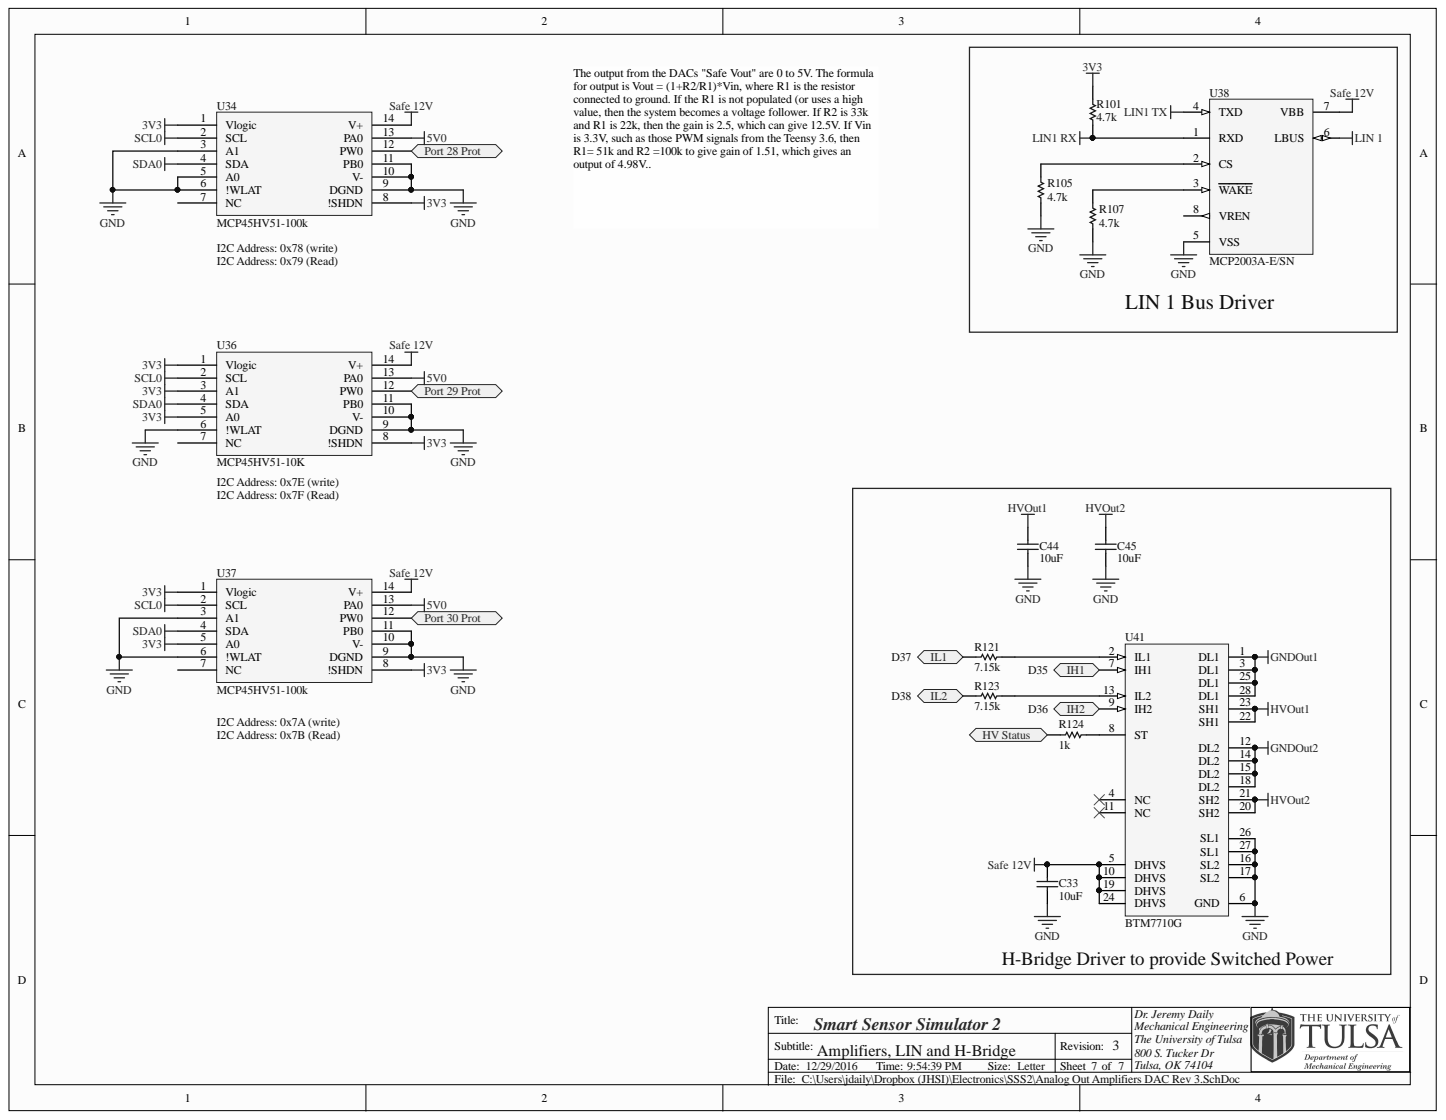
[picture p20: page 7]

The output from the DACs "Safe Vout" are 0 to 5V. The formula
for output is Vout = (1+R2/R1)*Vin, where R1 is the resistor
connected to ground. If the R1 is not populated (or uses a high
value, then the system becomes a voltage follower. If R2 is 33k
and R1 is 22k, then the gain is 2.5, which can give 12.5V. If Vin
is 3.3V, such as those PWM signals from the Teensy 3.6, then
R1= 51k and R2 =100k to give gain of 1.51, which gives an
output of 4.98V..

C44 GND | C45 U41

SDA 4

GND
H-Bridge Driver to provide Switched Power

Title: Smart Sensor Simulator 2 | Dr. Jeremy Daily

Amplifiers, LIN and H-Bridge | 3

C:\Users\jdaily\Dropbox (JHSI)\Electronics\SSS2\Analog Out Amplifiers DAC Rev 3.SchDoc
