jeremy-daily/SSS2/(commit log)

2017-02-13 Updated with CAT BSX Cable Design and Settings
    [SSS2 Settings Register for CAT BXS.csv]
2017-04-08 Prilimnary work on Threaded CAN
    Need more that 16 messages.
2017-04-09 Working CAN With Threads
2017-04-11 Improved Documentation
    [SSS2 Settings Register for CAT BXS.csv]
2017-04-15 Testing CAN threads
    Can send message arrays in a sequence.
2017-04-22 Revert "Added network logger functions."
    This reverts commit 7b85c171e0bb16061da19410c04dd65908f027ac.
    [SSS2_functions.h]
2017-05-06 Release for Widespread Use
    This is the release version for Rev3 boards.
2017-05-15 Created a readme and added rev5 Schematics
2017-05-28 Fixes after Testing PWMs
    [SSS2_Firmware.ino, SSS2_board_defs_rev_5.h, SSS2_functions.h]
2017-06-04 Raw CAN instead of ASCII over Serial
    Keeps the data from getting garbled. Still will drop some frames.
2017-06-05 Fixed overflow on clearcan
    [SSS2_Firmware.ino, SSS2_functions.h]
2017-07-21 Fixed Thread Name use in library
2018-05-16 changed wiring library
    Needs to be fixed
    [01_button_and_LEDs.ino, 02_Serial_Print.ino, SSS2_Firmware.ino, SSS2_functions.h]
2018-05-19 Updated wire library calls
2018-05-27 HAve new i2c_t3 working.
    [Frame Definitions.xlsx]
2018-05-31 Knob and LED tests
2018-06-02 Changed to 400k for I2C
